havandat1523/School-Bus-Device/Doc/Hardware_design/master_PCB.png

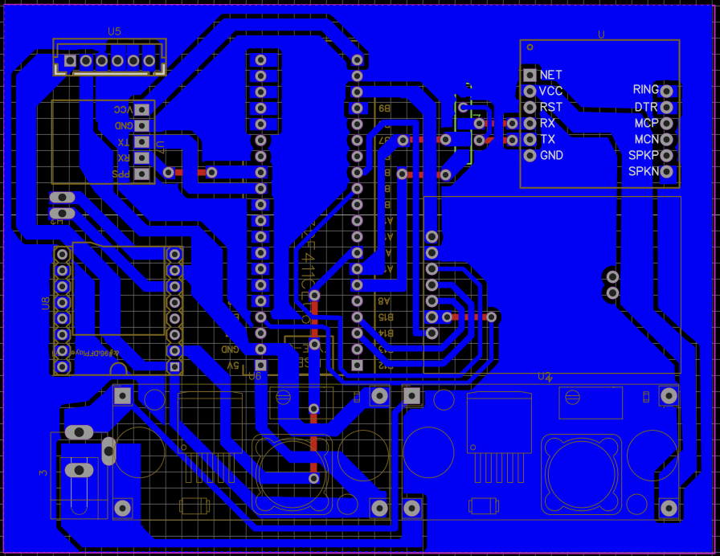
Doc/Hardware_design/master_PCB.png
