havandat1523/School-Bus-Device/Doc/Hardware_design/Slave_PCB_1.png

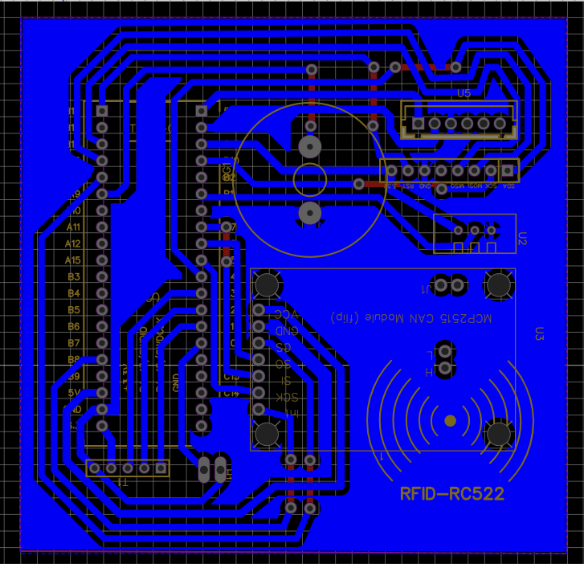
Doc/Hardware_design/Slave_PCB_1.png
