havandat1523/School-Bus-Device/Doc/Sequence_diagram/1.login_suscessful.png

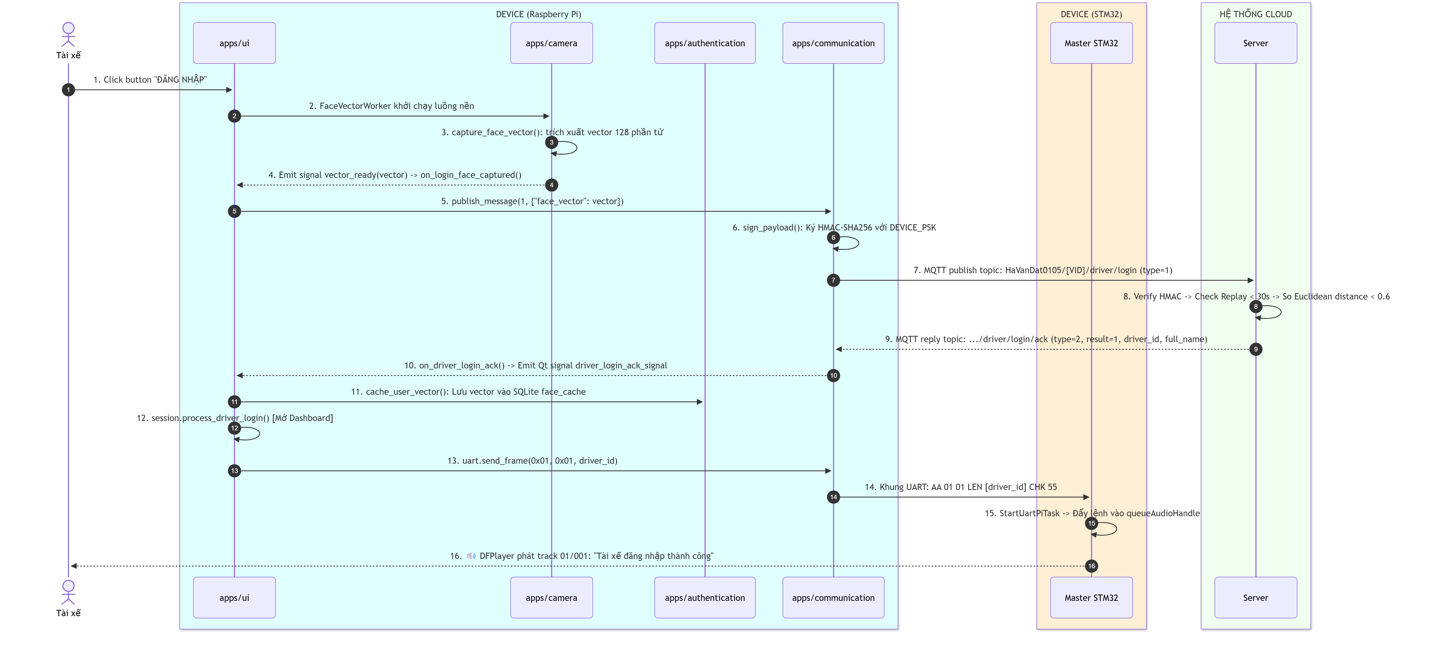
Doc/Sequence_diagram/1.login_suscessful.png
