havandat1523/School-Bus-Device/Doc/Sequence_diagram/2.Login_Failed.png

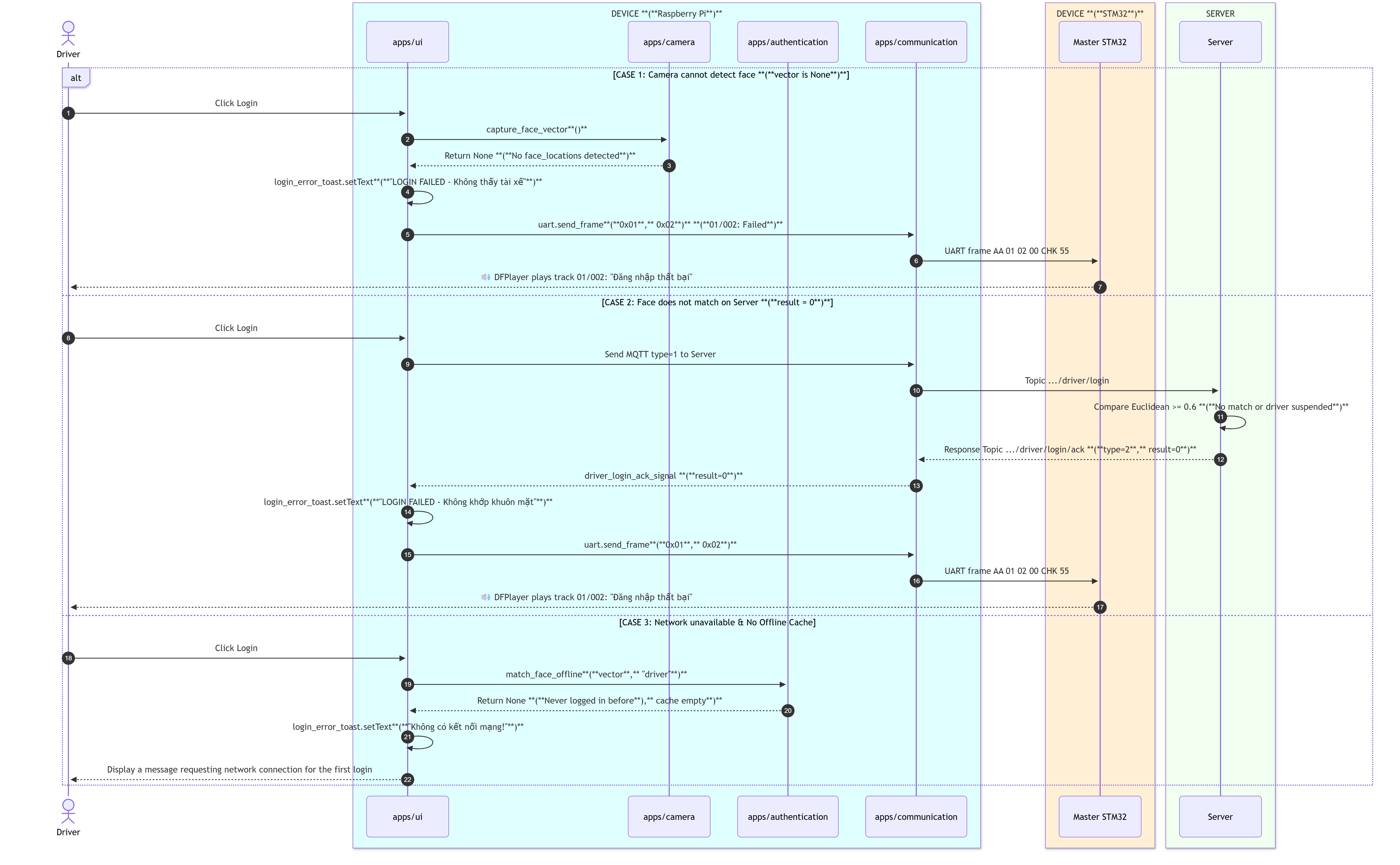
Doc/Sequence_diagram/2.Login_Failed.png
