havandat1523/School-Bus-Device/Doc/Sequence_diagram/3.Attandee_login_suscessful.png

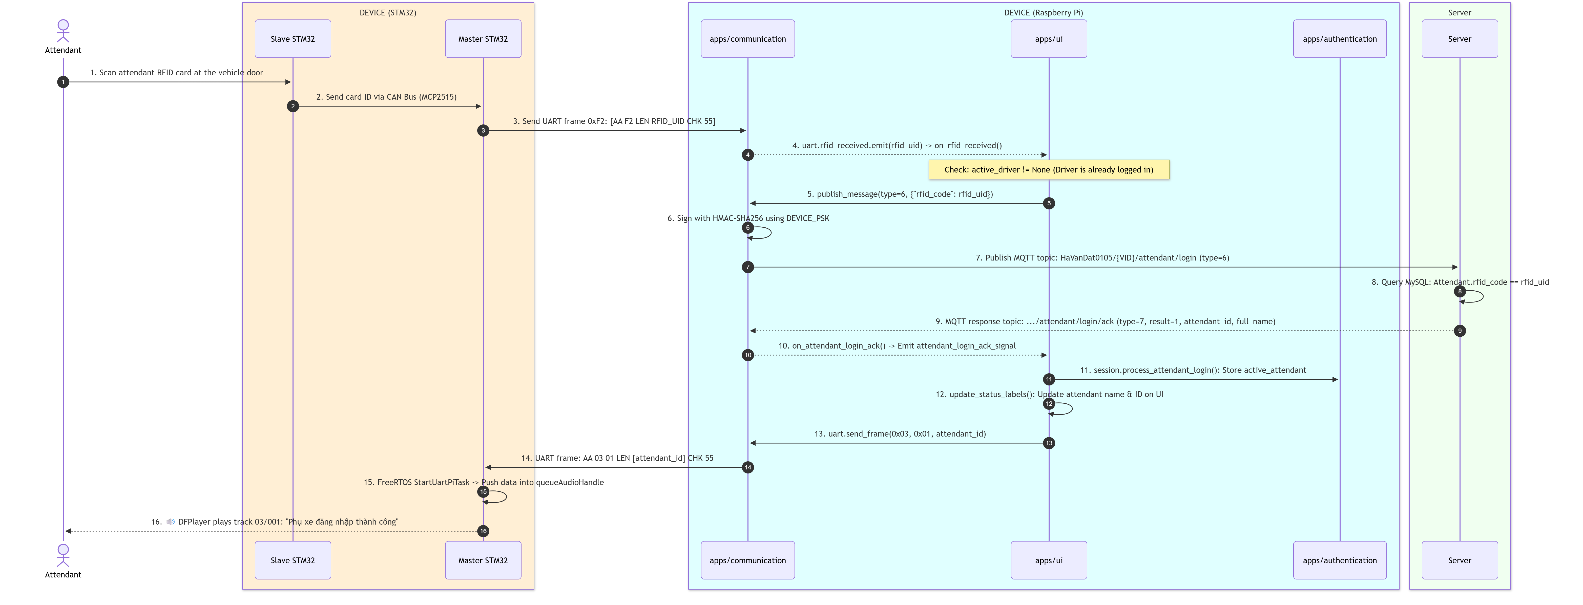
Doc/Sequence_diagram/3.Attandee_login_suscessful.png
