havandat1523/School-Bus-Device/Doc/Sequence_diagram/4.Attandee_login_failded.png

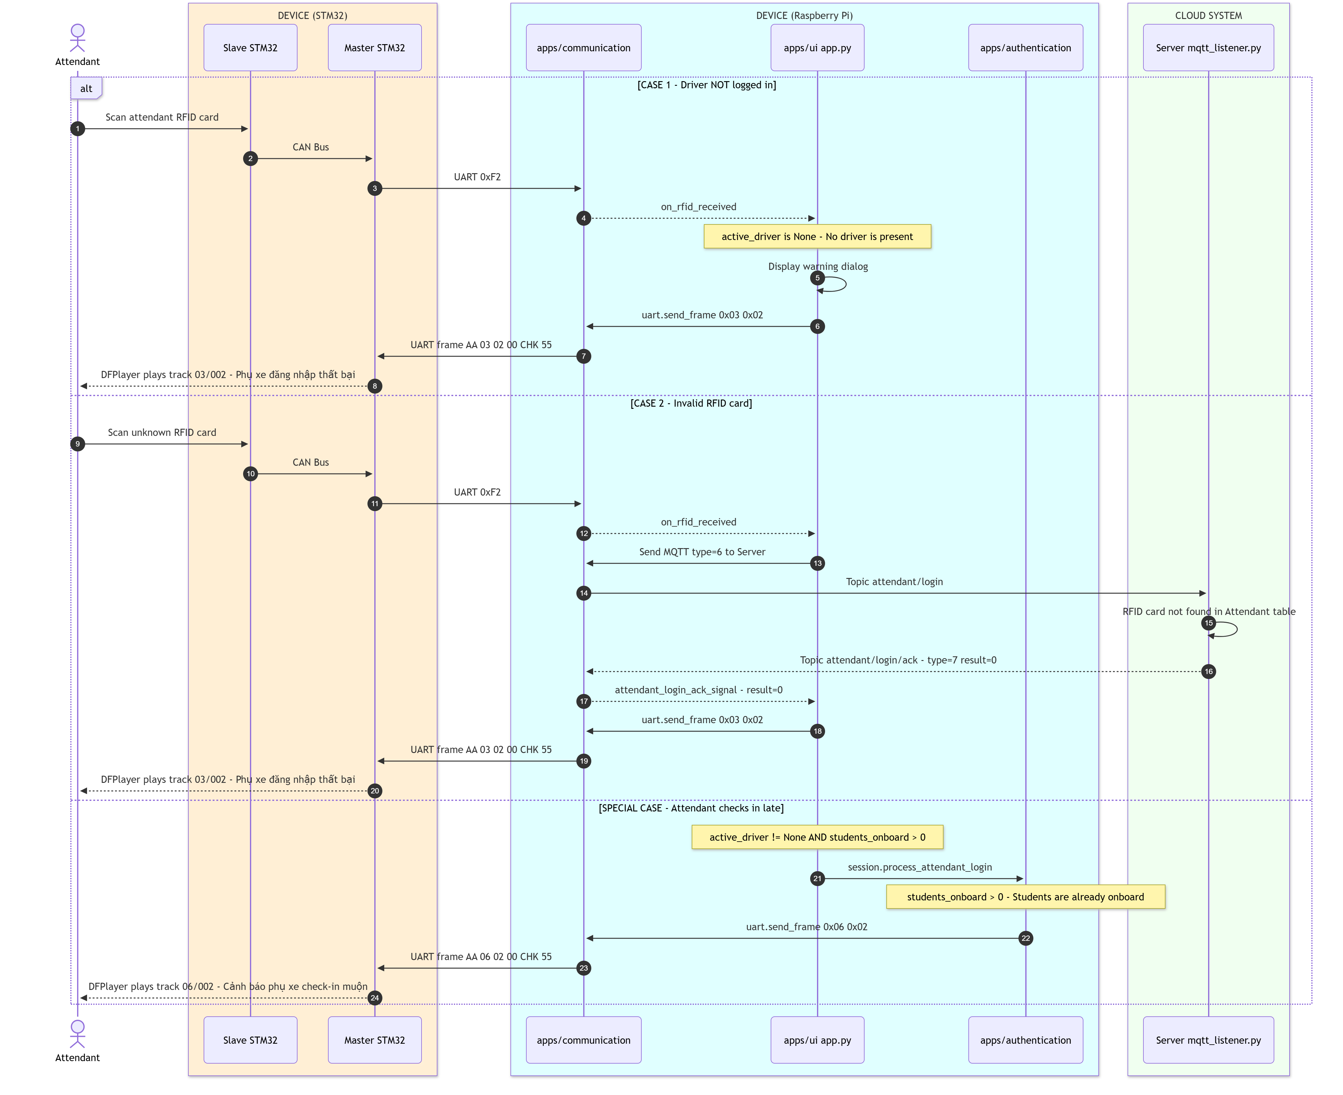
Doc/Sequence_diagram/4.Attandee_login_failded.png
