havandat1523/School-Bus-Device/Doc/Sequence_diagram/driver_send_SOS.png

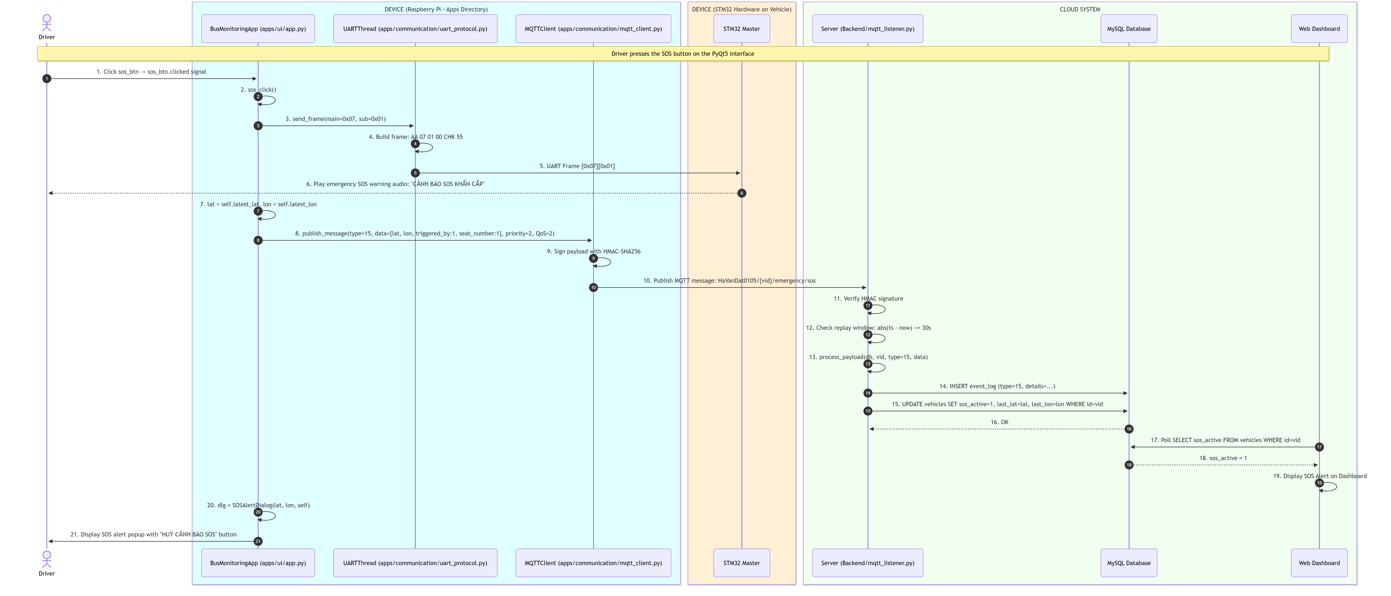
Doc/Sequence_diagram/driver_send_SOS.png
