havandat1523/School-Bus-Device/Doc/Sequence_diagram/Dropoff.png

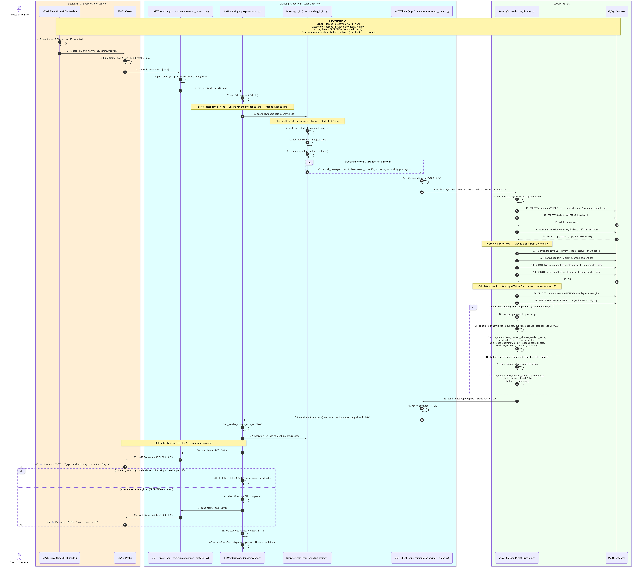
Doc/Sequence_diagram/Dropoff.png
