havandat1523/School-Bus-Device/Doc/Sequence_diagram/hocsinhquenquetthe.png

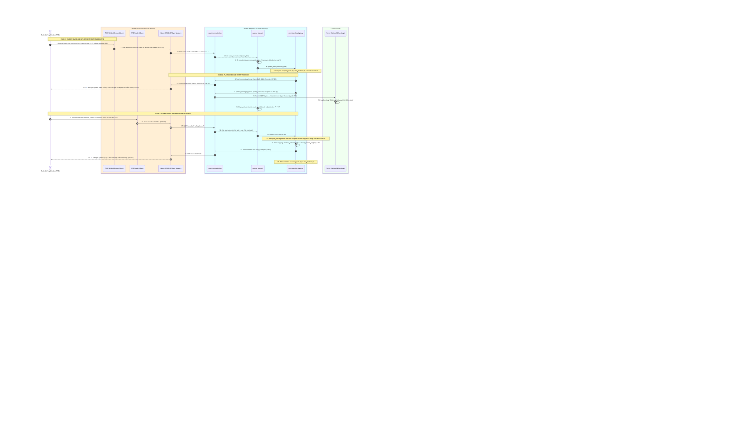
Doc/Sequence_diagram/hocsinhquenquetthe.png
