havandat1523/School-Bus-Device/Doc/Sequence_diagram/interval_gnss.png

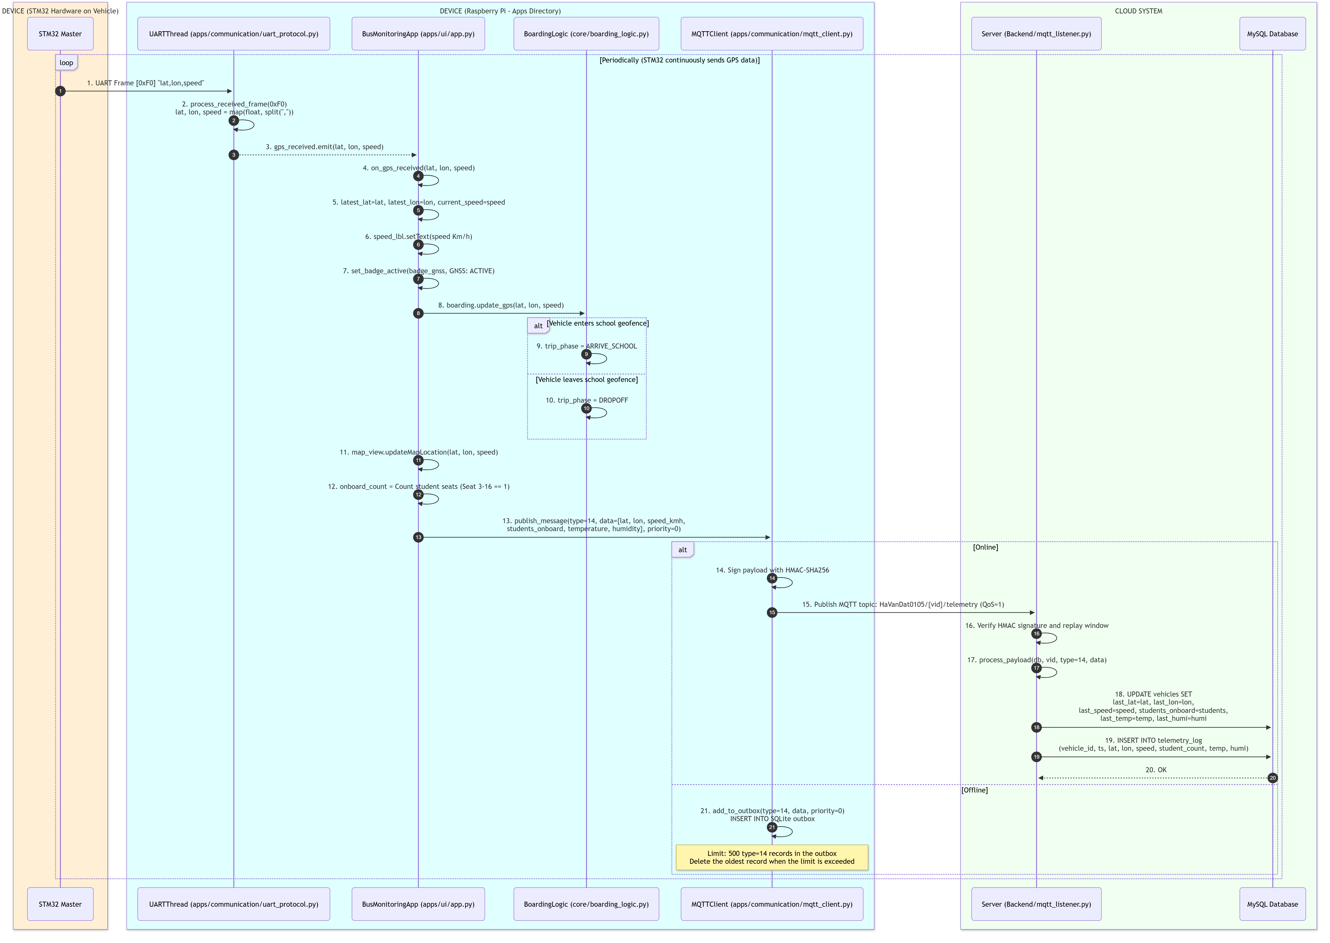
Doc/Sequence_diagram/interval_gnss.png
