havandat1523/School-Bus-Device/Doc/Sequence_diagram/interval_seat_thread.png

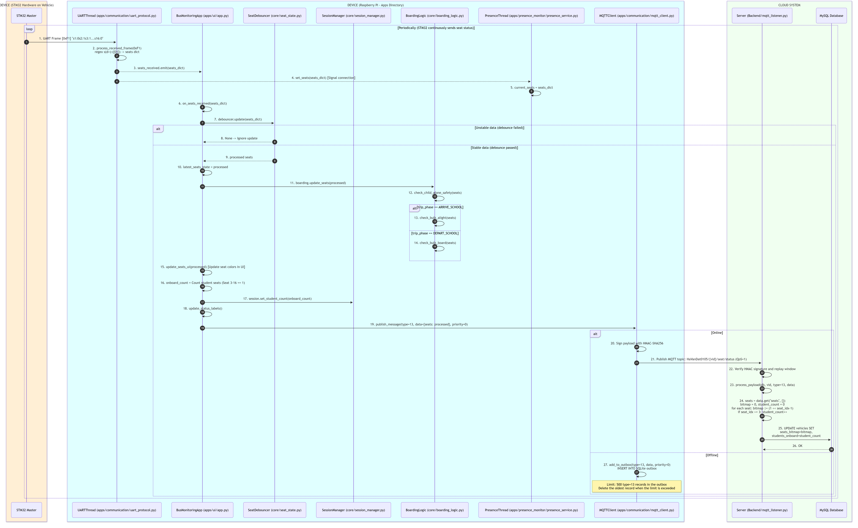
Doc/Sequence_diagram/interval_seat_thread.png
