havandat1523/School-Bus-Device/Doc/Sequence_diagram/pickup.png

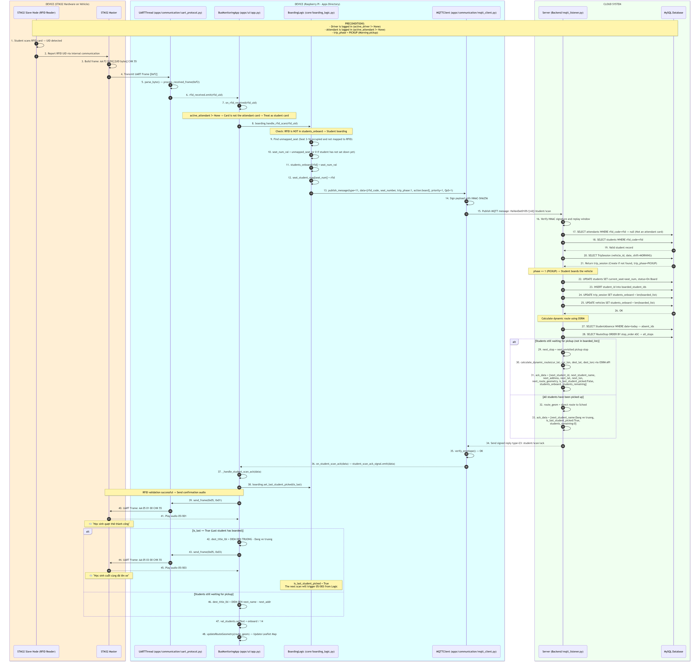
Doc/Sequence_diagram/pickup.png
