havandat1523/School-Bus-Device/Doc/Sequence_diagram/student_alone.png

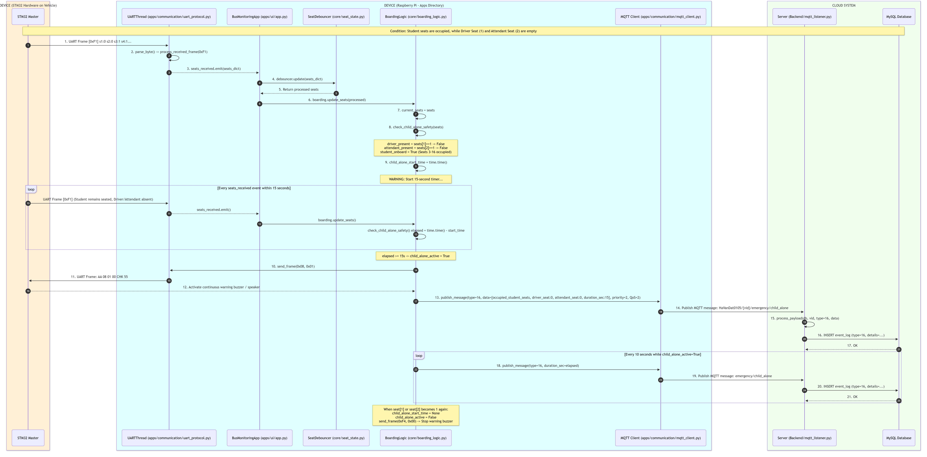
Doc/Sequence_diagram/student_alone.png
