havandat1523/School-Bus-Device/Doc/Sequence_diagram/trigger_SOS_physic_button.png

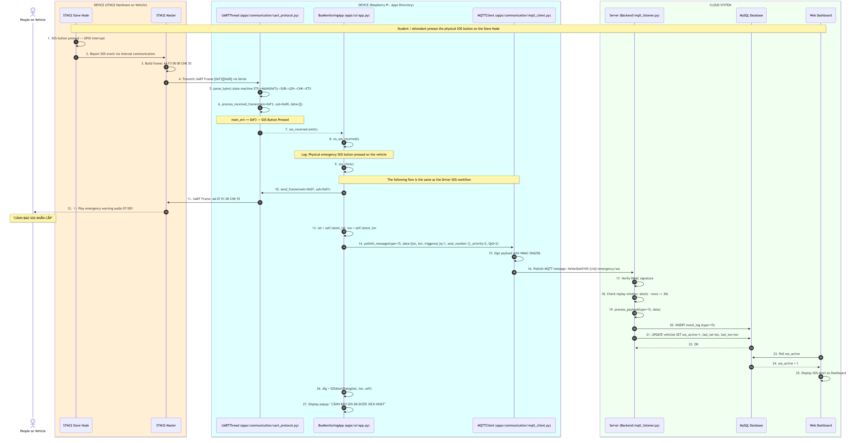
Doc/Sequence_diagram/trigger_SOS_physic_button.png
