havandat1523/School-Bus-Device/Doc/Sequence_diagram/violation_driver_attandee.png

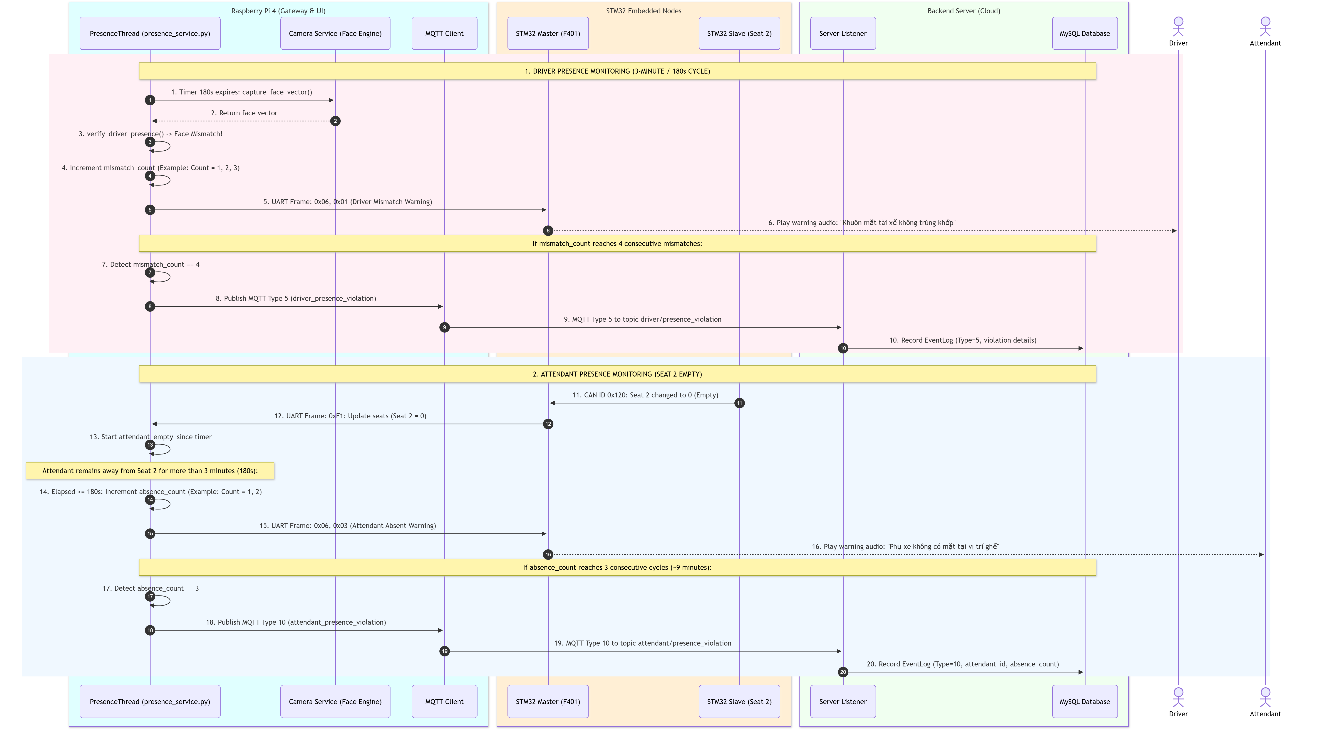
Doc/Sequence_diagram/violation_driver_attandee.png
