havandat1523/School-Bus-Device/Doc/Hardware_design/Master.pdf

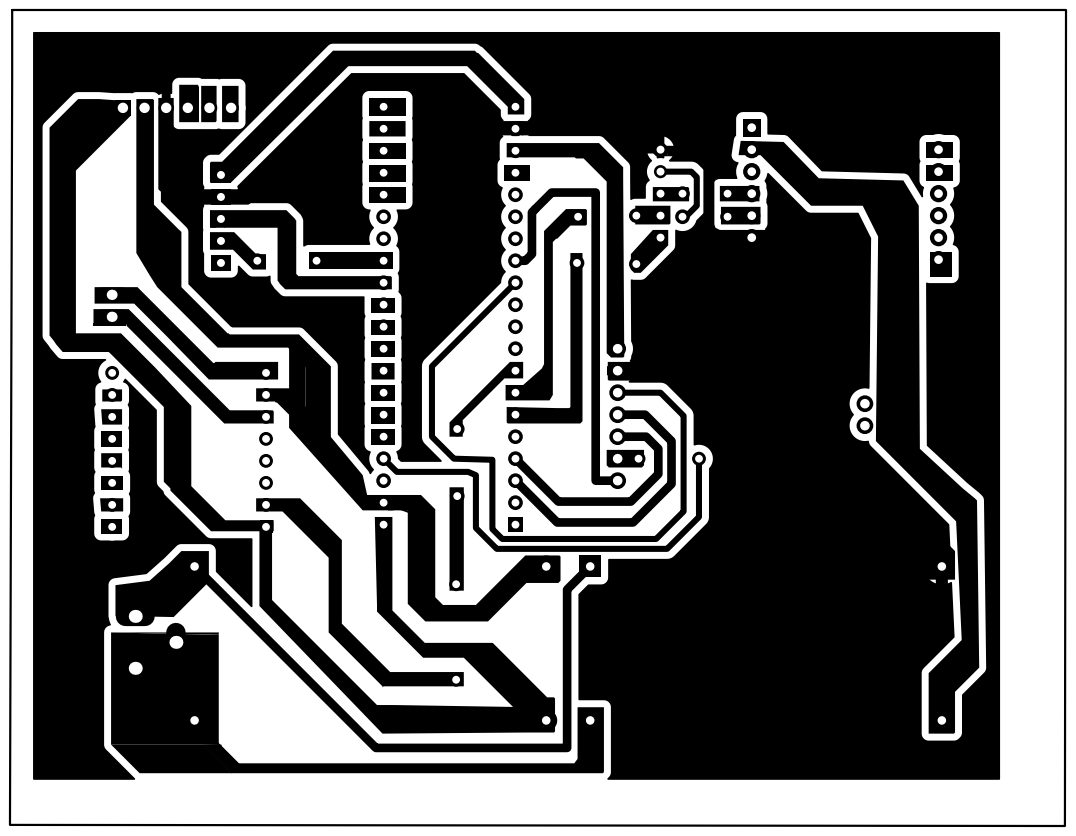
[picture p32: page 1]
