havandat1523/School-Bus-Device/Doc/Hardware_design/slave_1.pdf

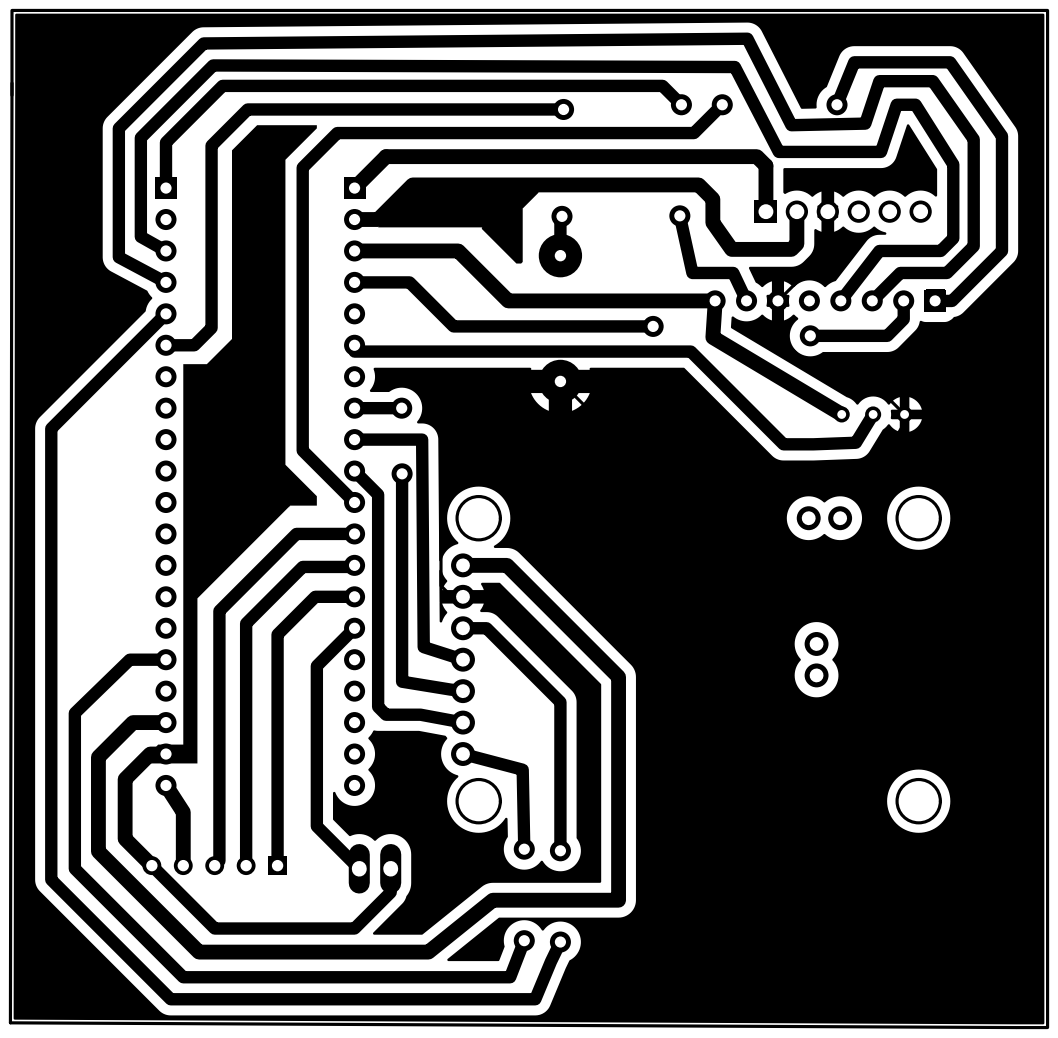
[picture p33: page 1]
