havandat1523/School-Bus-Device/Doc/Hardware_design/slave_2.pdf

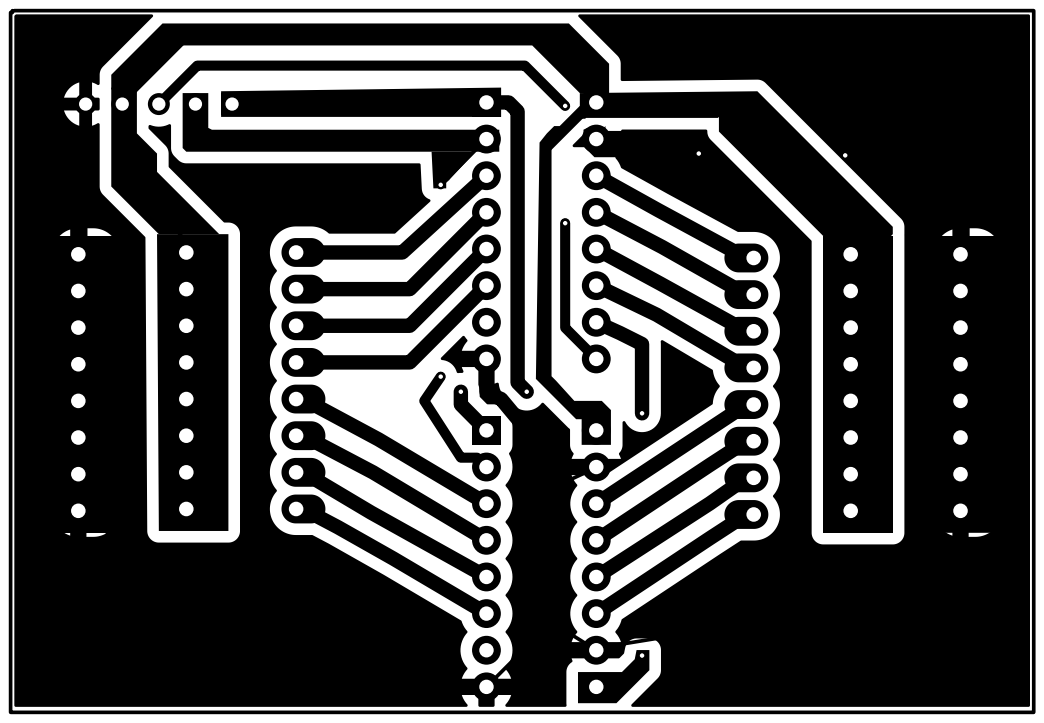
[picture p34: page 1]
