havandat1523/School-Bus-Device/Doc/UI_design/design_do_an.pdf

Giao diện đăng nhập

Số điện thoại của phụ huynh được lưu ở database Mật khẩu là mã thẻ của học sinh

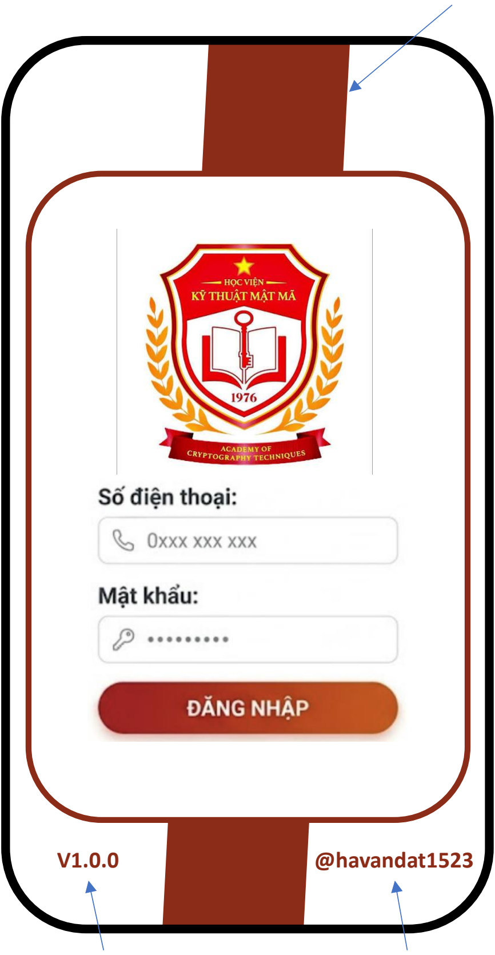
[picture p35: figure]
@havandat1523

Hai cái này lưu cứng ở đây , rất quan trọng

Cái thanh này làm cho nó chuyển động từ trái sang phải nếu làm cho nó dần chuyển màu giữa nâu đỏ và cam thì càng tốt

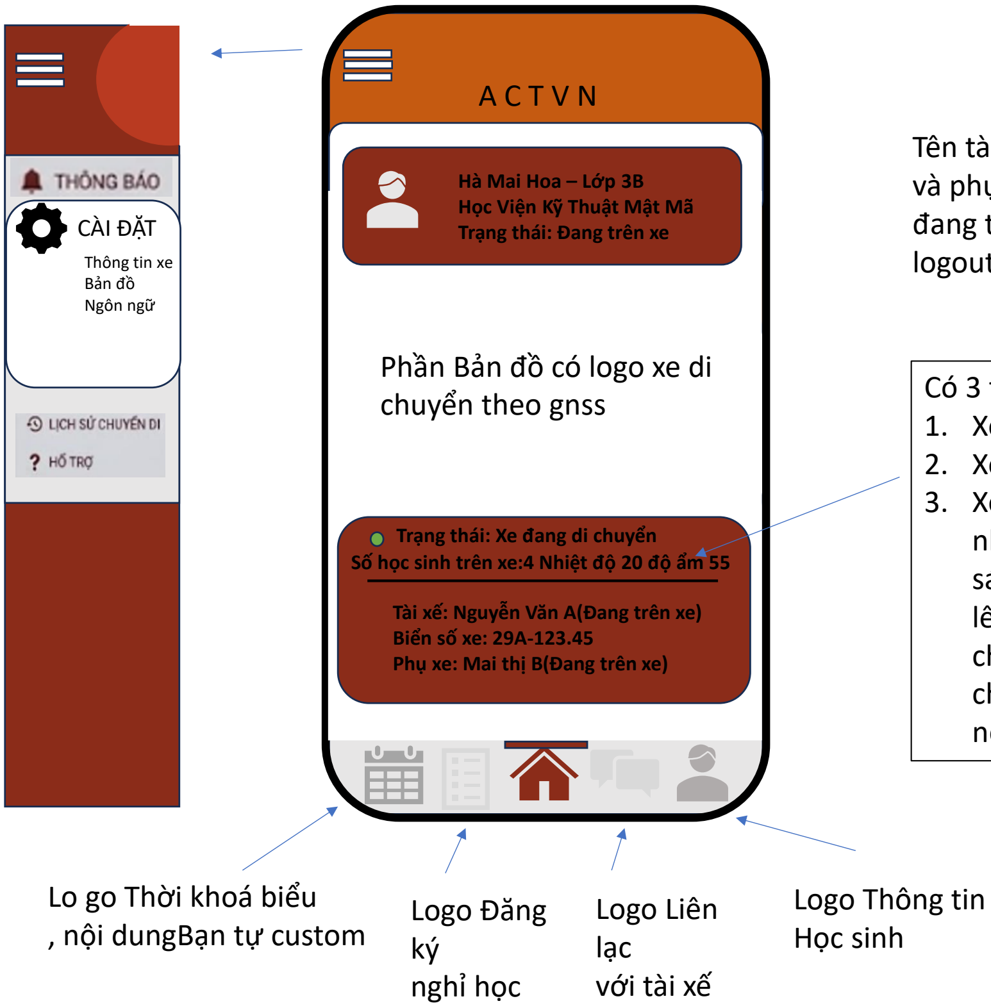
[picture p36: figure]
CÀI ĐẶT; Thông tin xe Bản đồ Ngôn ngữ; Tài xế: Nguyễn Văn A(Đang trên xe) Biển số xe: 29A-123.45 Phụ xe: Mai thị B(Đang trên xe); Trạng thái: Xe đang di chuyển; Hà Mai Hoa – Lớp 3B Học Viện Kỹ Thuật Mật Mã Trạng thái: Đang trên xe; Phần Bản đồ có logo xe di chuyển theo gnss; Lo go Thời khoá biểu , nội dungBạn tự custom; Logo Đăng ký nghỉ học; Logo Liên lạc với tài xế; Logo Thông tin Học sinh

Có 3 trạng thái của xe:
1. Xe đang dừng (tài xế log out)
2. Xe đang di chuyển
3. Xe đang đến vị trí của bạn(xác nhận khi học sinh trong danh sách trước học sinh này vừa lên xe nghĩa là xe đang di chuyển đến đón học sinh này, chuyển lại xe đang di chuyển nếu học sinh đang trên xe )

Tên tài xế + Phụ xe dựa theo tài xế và phụ xe login , chỉ có trạng thái đang trên xe ,nếu đang trạng thái logout thì sẽ là : không xác định

Số học sinh trên xe:4 Nhiệt độ 20 độ ẩm 55

Về số học sinh trên xe , nhiệt độ độ ẩm chỉ cập nhật khi tài xế login, nếu tài xế logout ghi không xác định

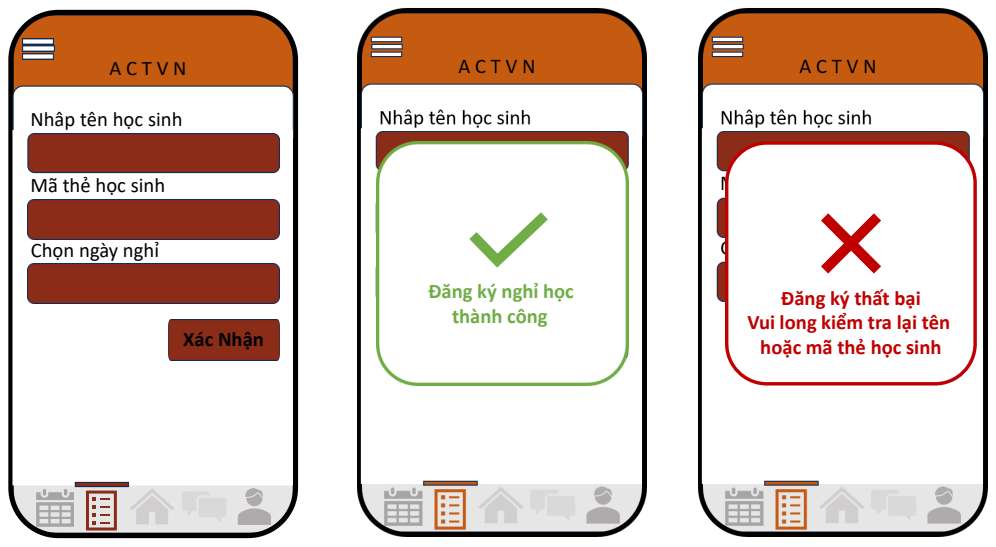
[picture p37: page 3]
Xác Nhận

Nhâp tên học sinh

Mã thẻ học sinh

Chọn ngày nghỉ

Đăng ký nghỉ học
thành công

Đăng ký thất bại
Vui long kiểm tra lại tên
hoặc mã thẻ học sinh

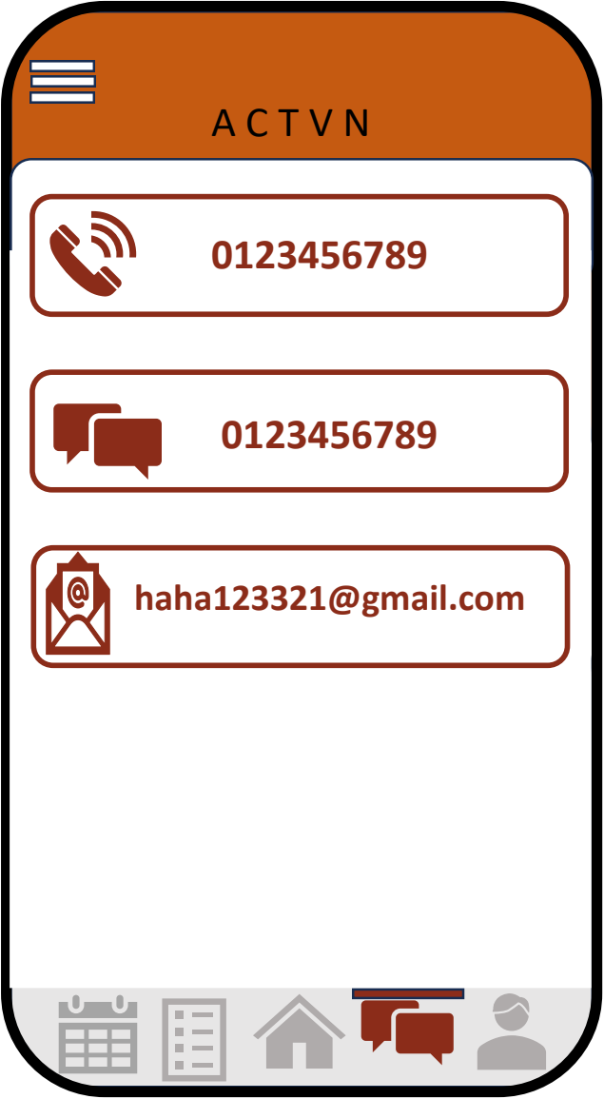
[picture p38: figure]
haha123321@gmail.com

Nếu phần liên lạc với tài xế sẽ hiển thị số điện thoại, gmail mà tài xế đã login, nếu chưa có tài xế login thì nó sẽ hiện : Chưa xác định. Nhấn logo nào sẽ mở app tương ứng trên điện thoại

Phần học sinh vẫn làm tương tự hiển thị các trường thông tin như họ tên , trường học , mã thẻ, tên phụ huynh , số điện thoại phụ huynh, địa chỉ

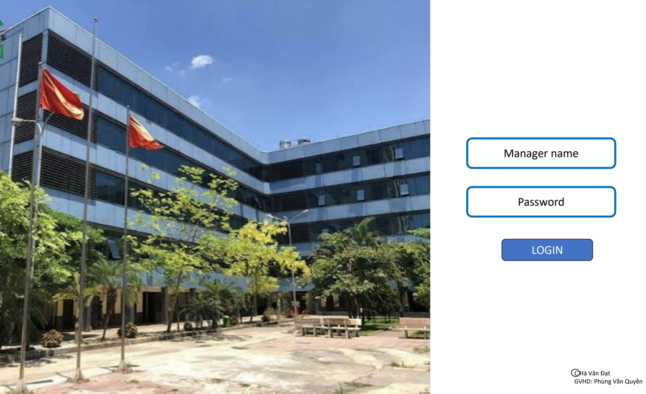
[picture p39: page 5]

Manager name

Password

LOGIN

C Hà Văn Đạt
GVHD: Phùng Văn Quyền

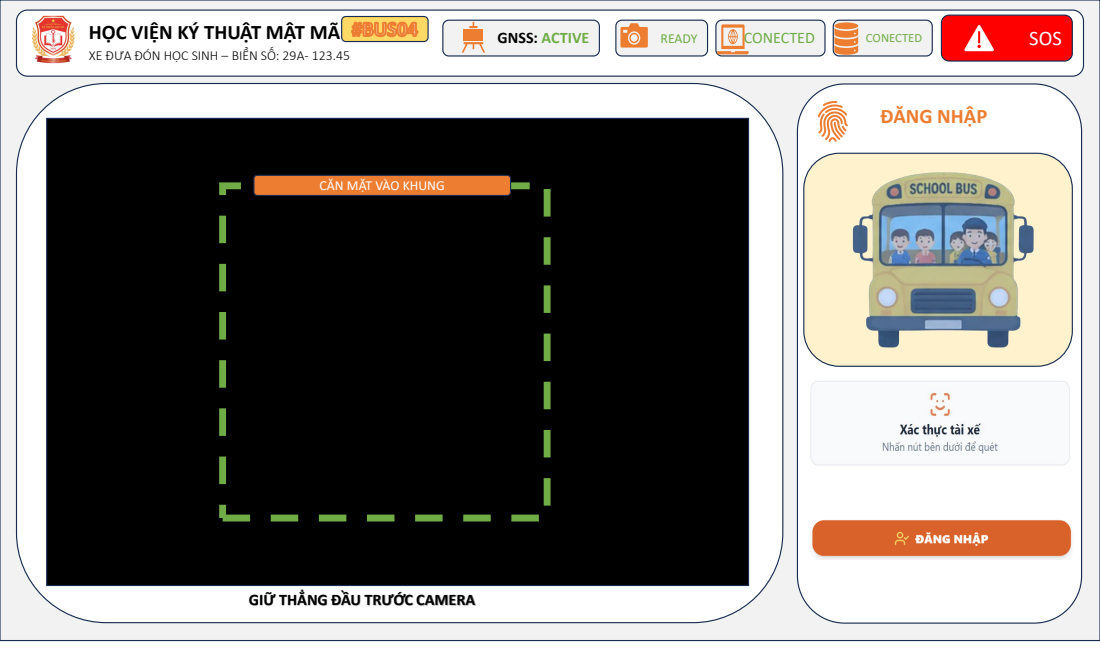
[picture p40: page 6]
HỌC VIỆN KÝ THUẬT MẬT MÃ; GNSS: ACTIVE; READY; CONECTED; SOS; #BUS04; ĐĂNG NHẬP

XE ĐƯA ĐÓN HỌC SINH – BIỂN SỐ: 29A- 123.45

CĂN MẶT VÀO KHUNG

GIỮ THẲNG ĐẦU TRƯỚC CAMERA

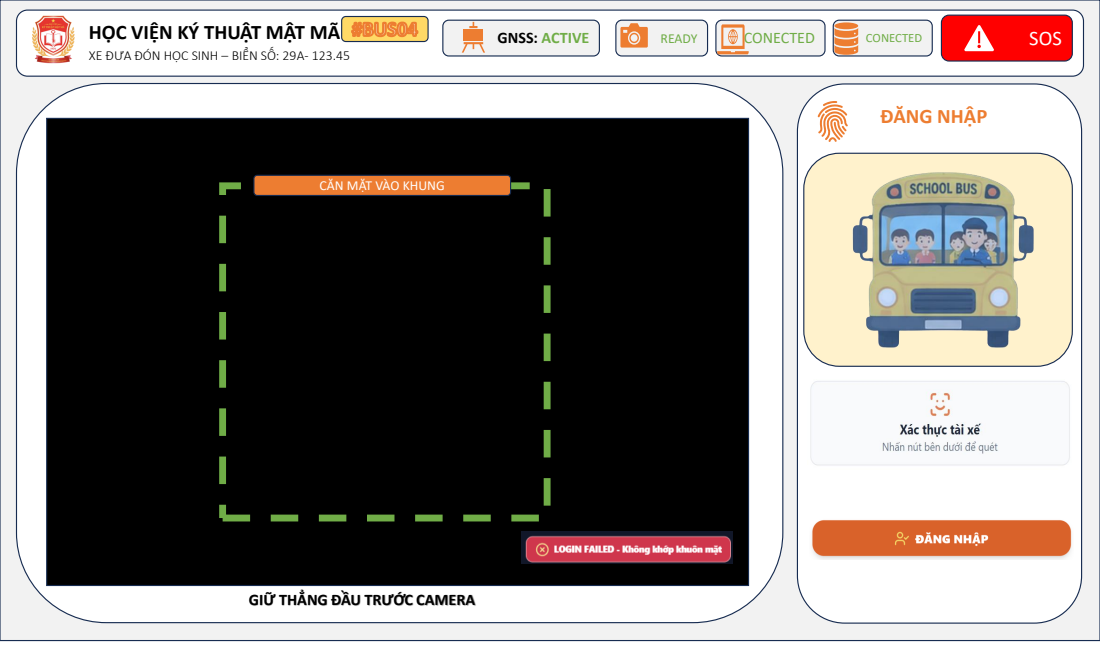
[picture p41: page 7]
ĐĂNG NHẬP

XE ĐƯA ĐÓN HỌC SINH – BIỂN SỐ: 29A- 123.45

CĂN MẶT VÀO KHUNG

GIỮ THẲNG ĐẦU TRƯỚC CAMERA

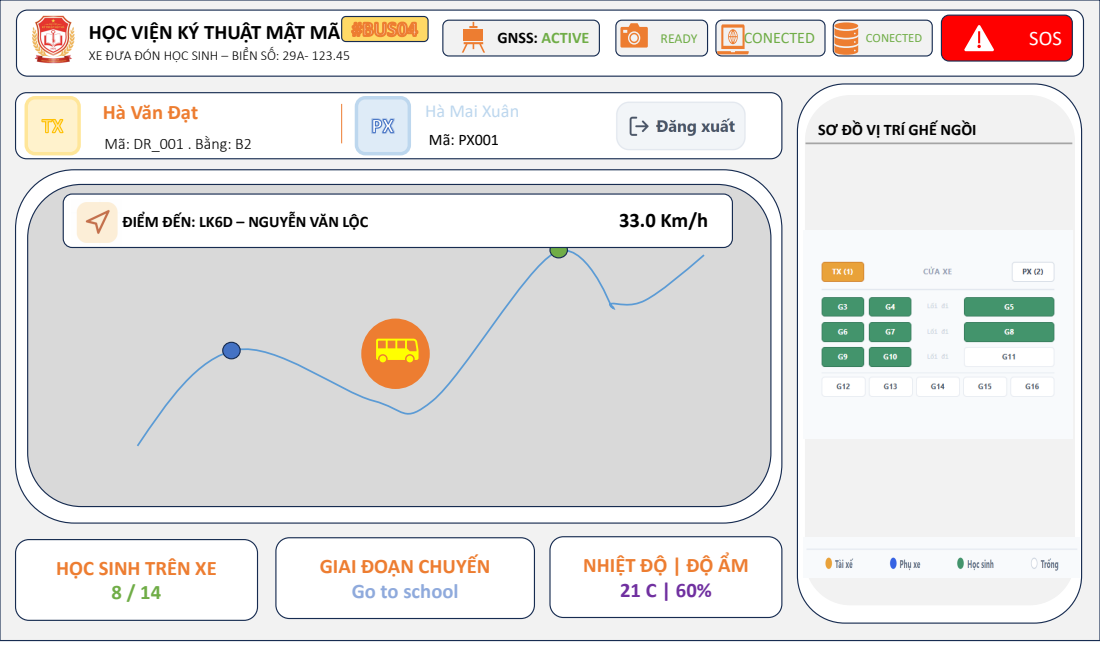
[picture p42: page 8]
Mã: DR_001 . Bằng: B2; ĐIỂM ĐẾN: LK6D – NGUYỄN VĂN LỘC

XE ĐƯA ĐÓN HỌC SINH – BIỂN SỐ: 29A- 123.45

Hà Văn Đạt

Hà Mai Xuân

SƠ ĐỒ VỊ TRÍ GHẾ NGỒI

GIAI ĐOẠN CHUYẾN
Go to school

NHIỆT ĐỘ | ĐỘ ẨM

HỌC SINH TRÊN XE

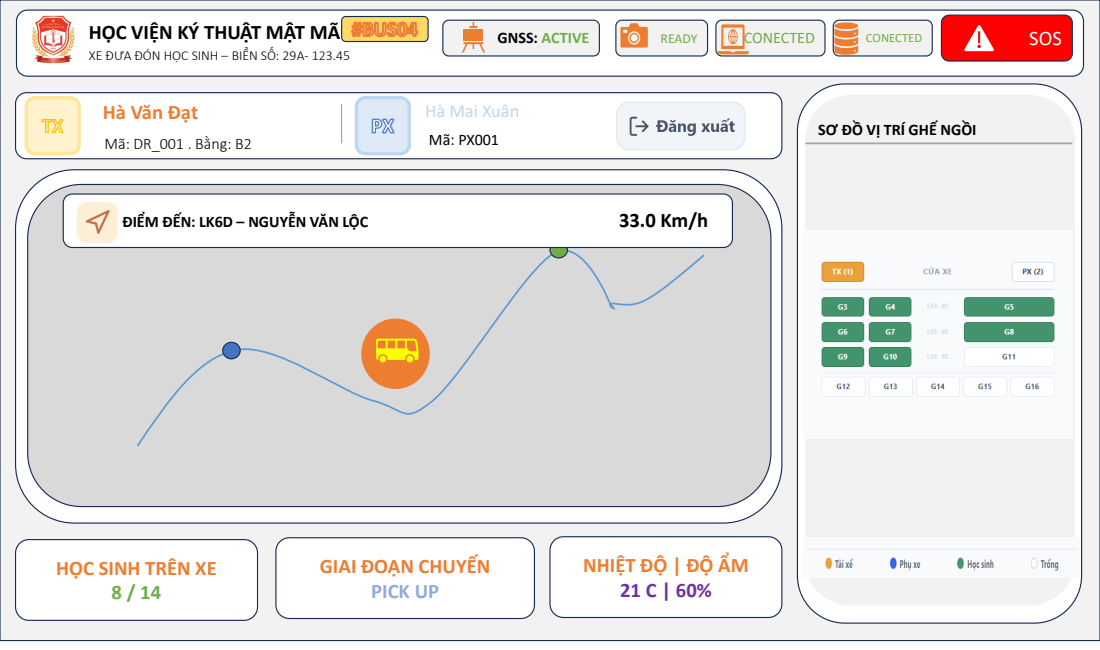
[picture p43: page 9]
Mã: DR_001 . Bằng: B2; ĐIỂM ĐẾN: LK6D – NGUYỄN VĂN LỘC

XE ĐƯA ĐÓN HỌC SINH – BIỂN SỐ: 29A- 123.45

Hà Văn Đạt

Hà Mai Xuân

SƠ ĐỒ VỊ TRÍ GHẾ NGỒI

GIAI ĐOẠN CHUYẾN
PICK UP

NHIỆT ĐỘ | ĐỘ ẨM

HỌC SINH TRÊN XE

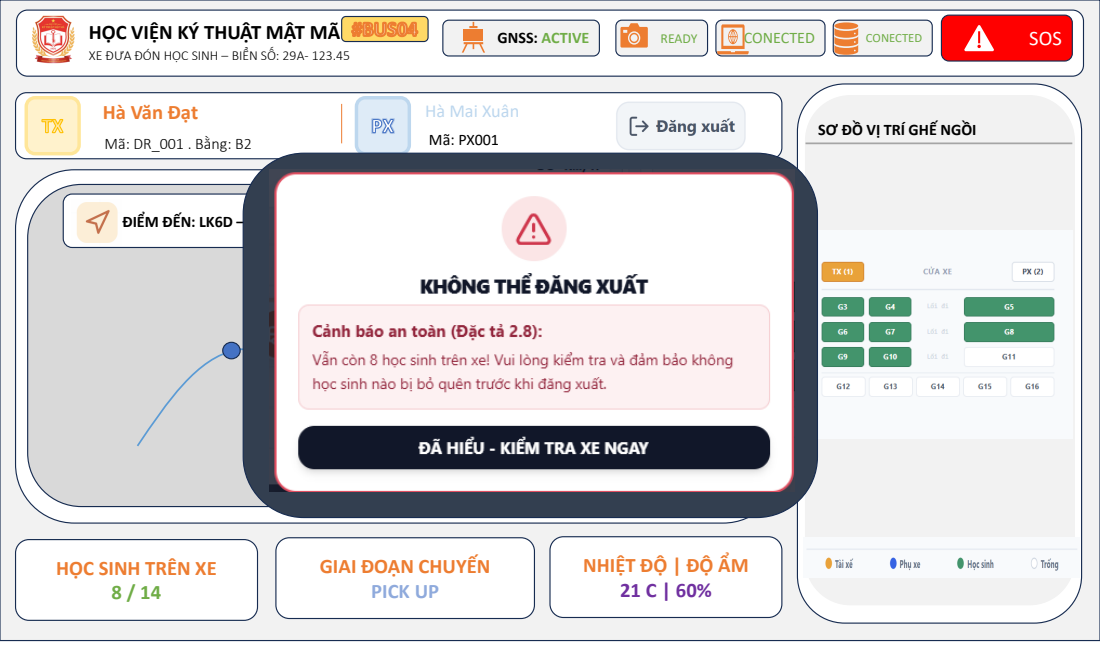
[picture p44: page 10]
Mã: DR_001 . Bằng: B2; ĐIỂM ĐẾN: LK6D – NGUYỄN VĂN LỘC

XE ĐƯA ĐÓN HỌC SINH – BIỂN SỐ: 29A- 123.45

Hà Văn Đạt

Hà Mai Xuân

SƠ ĐỒ VỊ TRÍ GHẾ NGỒI

GIAI ĐOẠN CHUYẾN
PICK UP

NHIỆT ĐỘ | ĐỘ ẨM

HỌC SINH TRÊN XE

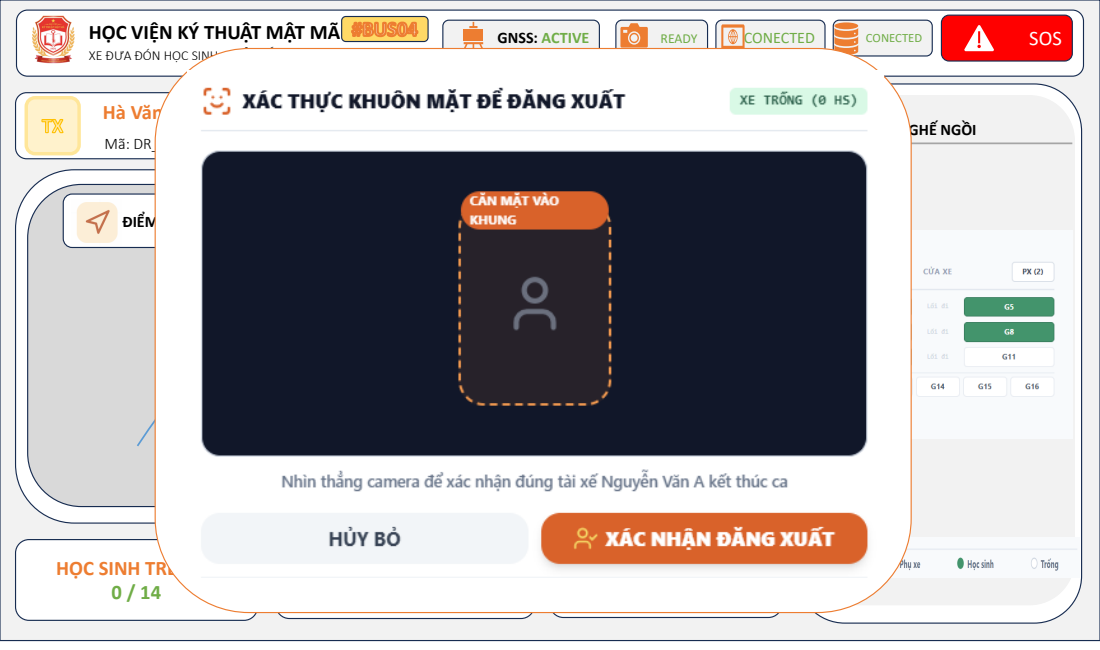
[picture p45: page 11]
Mã: DR_001 . Bằng: B2; ĐIỂM ĐẾN: LK6D – NGUYỄN VĂN LỘC

XE ĐƯA ĐÓN HỌC SINH – BIỂN SỐ: 29A- 123.45

Hà Văn Đạt

Hà Mai Xuân

SƠ ĐỒ VỊ TRÍ GHẾ NGỒI

GIAI ĐOẠN CHUYẾN
PICK UP

NHIỆT ĐỘ | ĐỘ ẨM

HỌC SINH TRÊN XE

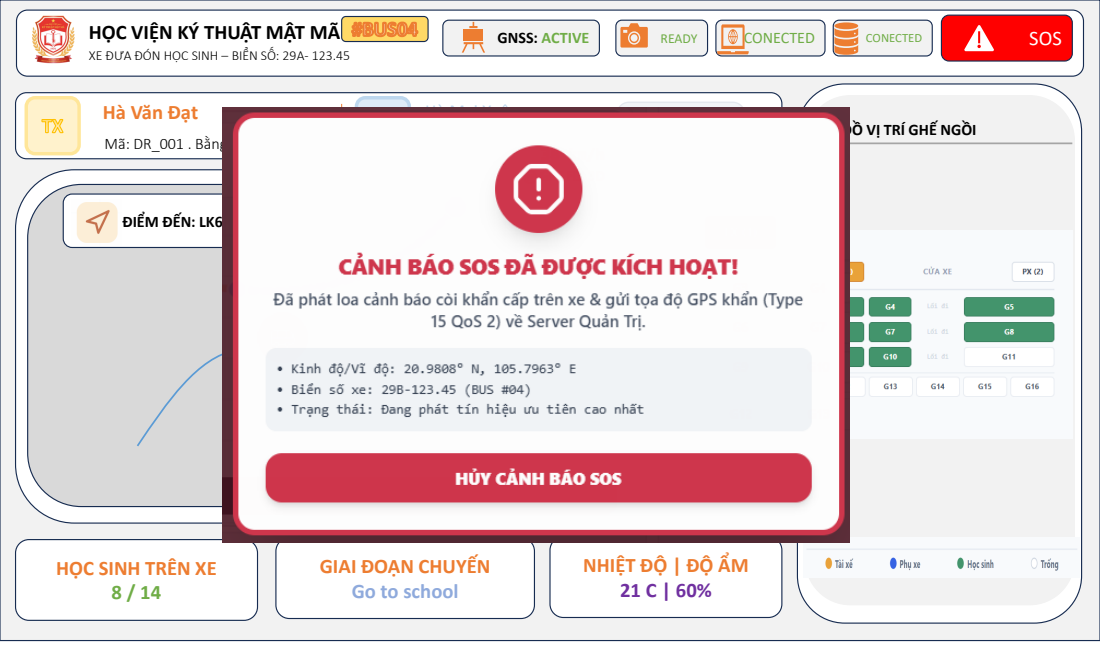
[picture p46: page 12]
Mã: DR_001 . Bằng: B2; ĐIỂM ĐẾN: LK6D – NGUYỄN VĂN LỘC

XE ĐƯA ĐÓN HỌC SINH – BIỂN SỐ: 29A- 123.45

Hà Văn Đạt

Hà Mai Xuân

SƠ ĐỒ VỊ TRÍ GHẾ NGỒI

GIAI ĐOẠN CHUYẾN
Go to school

NHIỆT ĐỘ | ĐỘ ẨM

HỌC SINH TRÊN XE
