havandat1523/School-Bus-Device/RaspberryPi/main.py

import sys
import os
from PyQt5.QtWidgets import QApplication
from config import config
from services.logger import get_logger
from services.database import init_db
from apps.communication.uart_protocol import UARTThread
from apps.communication.mqtt_client import MQTTClient
from apps.communication.payload_handler import PayloadHandler
from apps.camera.camera_service import CameraService
from apps.authentication.auth_service import AuthService
from apps.presence_monitor.presence_service import PresenceThread
from core.session_manager import SessionManager
from core.boarding_logic import BoardingLogic
from core.seat_state import SeatDebouncer
from apps.gpio_handler.gpio_handler import GPIOHandler
from apps.ui.app import BusMonitoringApp

logger = get_logger("Main")

def main():
    logger.info("==============================================")
    logger.info("Starting School Bus Gateway Application...")
    logger.info("VEHICLE ID: %s", config.VEHICLE_ID)
    logger.info("DISPLAY: %s", os.environ.get("DISPLAY", "Not Set"))
    logger.info("==============================================")

    # 1. Initialize PyQt5 GUI Application first (Qt core requirement)
    app = QApplication(sys.argv)

    # 2. Initialize SQLite Database
    init_db()

    # 3. Instantiate core services
    auth_service = AuthService()

    # 4. Instantiate thread components
    camera_service = CameraService()
    uart_thread = UARTThread()

    # 5. Instantiate MQTT client
    mqtt_client = MQTTClient()

    # 6. Instantiate managers & logic layers
    session_manager = SessionManager(auth_service, uart_thread, mqtt_client)
    boarding_logic = BoardingLogic(uart_thread, mqtt_client)

    # F1+F2: SeatDebouncer nhận callback → khi ghế học sinh 0→1 trigger finalize boarding
    seat_debouncer = SeatDebouncer(
        on_seat_occupied=boarding_logic._try_finalize_boarding
    )

    # F1+F2+F3: PayloadHandler xử lý lệnh từ Server và quản lý SOS
    payload_handler = PayloadHandler(
        boarding_logic=boarding_logic,
        uart_thread=uart_thread,
        mqtt_client=mqtt_client,
        session_manager=session_manager
    )

    # Gán payload_handler vào mqtt_client để nhận type=20 action F1/F2
    mqtt_client.payload_handler = payload_handler

    # 7. Instantiate presence check thread
    presence_thread = PresenceThread(auth_service, camera_service, uart_thread, mqtt_client)

    # 8. Create main UI window & connect signals
    ui_app = BusMonitoringApp(
        uart_thread=uart_thread,
        mqtt_client=mqtt_client,
        camera_service=camera_service,
        auth_service=auth_service,
        session_manager=session_manager,
        boarding_logic=boarding_logic,
        seat_debouncer=seat_debouncer,
        payload_handler=payload_handler
    )

    # Link MQTT callback receiver to UI
    mqtt_client.callback_handler = ui_app

    # Wire seat updates: UART → SeatDebouncer callback → boarding_logic
    uart_thread.seats_received.connect(presence_thread.set_seats)

    # Wire RFID signal: UART → boarding_logic F2 queue (thay vì gọi trực tiếp)
    # boarding_logic.handle_rfid_scan sẽ tự push vào pending queue và gửi validate
    uart_thread.rfid_received.connect(boarding_logic.handle_rfid_scan)

    # F4: GPIO Handler cho 2 nút bấm vật lý trên Pi (Login/Logout toggle và SOS 3s hold)
    gpio_handler = GPIOHandler(
        login_pin=config.GPIO_LOGIN_PIN,
        sos_pin=config.GPIO_SOS_PIN,
        sos_hold_sec=config.GPIO_SOS_HOLD_SEC,
        on_login_toggle=ui_app.on_gpio_login_toggle,
        on_sos_triggered=ui_app.on_gpio_sos_triggered,
        on_sos_progress=ui_app.on_gpio_sos_progress
    )

    # Show UI window
    ui_app.show()

    # 9. Start background threads AFTER QApplication, UI, and Signals are connected
    camera_service.start()
    uart_thread.start()
    mqtt_client.start()
    presence_thread.start()
    gpio_handler.start()

    # Execute Qt main event loop
    logger.info("UI Window launched. Entering Qt main loop.")
    exit_code = app.exec_()

    # Cleanup threads on exit
    logger.info("Shutting down threads...")
    gpio_handler.stop()
    camera_service.stop()
    uart_thread.stop()
    mqtt_client.stop()
    presence_thread.stop()
    logger.info("Application exited with code %d", exit_code)
    sys.exit(exit_code)

if __name__ == "__main__":
    main()
