havandat1523/School-Bus-Device/STM32/Slave/Core/Inc/main.h

#define SOS_KEY_Pin GPIO_PIN_0
#define SOS_KEY_GPIO_Port GPIOA
#define SOS_KEY_EXTI_IRQn EXTI0_IRQn
#define HC165_PL_Pin GPIO_PIN_1
#define HC165_PL_GPIO_Port GPIOA
#define HC165_CLK_Pin GPIO_PIN_2
#define HC165_CLK_GPIO_Port GPIOA
#define HC165_DATA_Pin GPIO_PIN_3
#define HC165_DATA_GPIO_Port GPIOA
#define RFID_CS_Pin GPIO_PIN_4
#define RFID_CS_GPIO_Port GPIOA
#define DHT11_PIN_Pin GPIO_PIN_1
#define DHT11_PIN_GPIO_Port GPIOB
#define RFID_RST_Pin GPIO_PIN_12
#define RFID_RST_GPIO_Port GPIOB
#define CAN_CS_Pin GPIO_PIN_8
#define CAN_CS_GPIO_Port GPIOA
#define CAN_INT_Pin GPIO_PIN_8
#define CAN_INT_GPIO_Port GPIOB
#define CAN_INT_EXTI_IRQn EXTI9_5_IRQn
#define BUZZER_Pin GPIO_PIN_9
#define BUZZER_GPIO_Port GPIOA
