havandat1523/School-Bus-Device/RaspberryPi/core/session_manager.py

from services.logger import get_logger

logger = get_logger("SessionManager")

class SessionManager:
    def __init__(self, auth_service, uart_thread, mqtt_client):
        self.auth = auth_service
        self.uart = uart_thread
        self.mqtt = mqtt_client
        self.students_onboard = 0
        self.driver_phone_number = None
        self.is_pending_confirm = False

    def set_pending_confirm(self, pending: bool):
        """Khóa hoặc mở khóa nút đăng nhập khi đang PENDING_CONFIRM."""
        self.is_pending_confirm = pending
        logger.info("Session pending_confirm state set to: %s", pending)

    def set_student_count(self, count: int):
        self.students_onboard = count

    def toggle_login_logout(self, student_count: int = 0) -> tuple:
        """
        F4: Nút GPIO vật lý 1 — Toggle Login / Logout.
        - Bị khoá khi PENDING_CONFIRM (đang chờ xác nhận trung tâm).
        - Chưa login → Trả về ("LOGIN_REQUEST", "")
        - Đã login → Kiểm tra can_driver_logout(), nếu thoả mãn thì trả về ("LOGOUT_REQUEST", "")
        Returns: (status: str, message: str)
        """
        if self.is_pending_confirm:
            logger.warning("F4: GPIO Login/Logout button LOCKED — session is PENDING_CONFIRM!")
            # 01/003: Hệ thống đang bận, vui lòng thử lại
            self.uart.send_frame(0x01, 0x03)
            return "LOCKED", "Hệ thống đang chờ trung tâm xác nhận phiên cũ, vui lòng thử lại sau!"

        if not self.auth.active_driver:
            logger.info("F4: GPIO button triggered driver LOGIN request")
            return "LOGIN_REQUEST", "Yêu cầu đăng nhập tài xế"

        # Đang có tài xế đăng nhập -> Yêu cầu đăng xuất
        can_logout, reason = self.can_driver_logout(student_count)
        if not can_logout:
            logger.warning("F4/F5: GPIO driver logout REJECTED: %s", reason)
            # F5: 02/004: Đăng xuất thất bại — còn học sinh hoặc phụ xe
            self.uart.send_frame(0x02, 0x04)
            return "REJECTED", reason

        logger.info("F4: GPIO button triggered driver LOGOUT request")
        return "LOGOUT_REQUEST", "Yêu cầu đăng xuất tài xế"

    def can_attendant_logout(self, student_count: int = 0) -> tuple:
        """
        Validates if the attendant is allowed to logout.
        Rule: Attendant can ONLY logout when NO students are left on board (all reached school or home).
        Returns (bool, reason_string).
        """
        if not self.auth.active_attendant:
            return False, "Không có phụ xe nào đang đăng nhập."
            
        effective_students = max(self.students_onboard, student_count)
        if effective_students > 0:
            return False, f"Vẫn còn {effective_students} học sinh trên xe! Phụ xe phải đợi tất cả học sinh xuống xe hết (đến trường hoặc về nhà) mới được đăng xuất."
            
        return True, ""

    def can_driver_logout(self, student_count: int = 0) -> tuple:
        """
        Validates if the driver is allowed to logout.
        Rule:
        1. Driver can only logout AFTER attendant has logged out.
        2. Driver can only logout when NO students are on board.
        Returns (bool, reason_string).
        """
        if not self.auth.active_driver:
            return False, "Không có tài xế nào đang đăng nhập."
            
        if self.auth.active_attendant:
            att_name = self.auth.active_attendant.get("full_name", "Phụ xe")
            return False, f"Phụ xe ({att_name}) vẫn còn trên xe! Phụ xe phải đăng xuất trước khi tài xế đăng xuất."
            
        effective_students = max(self.students_onboard, student_count)
        if effective_students > 0:
            return False, f"Vẫn còn {effective_students} học sinh trên xe! Tài xế không thể đăng xuất."
            
        return True, ""

    def process_driver_login(self, driver_id: str, full_name: str, face_vector: list = None, phone_number: str = None):
        """
        Saves the logged in driver profile.
        """
        self.driver_phone_number = phone_number
        self.auth.active_driver = {
            "driver_id": driver_id,
            "full_name": full_name,
            "face_vector": face_vector,
            "phone_number": phone_number
        }
        self.auth.mismatch_count = 0
        logger.info("Driver logged in: %s (%s, Phone: %s)", full_name, driver_id, phone_number)
        # Notify Master via UART to play 01/001 (driver login success)
        self.uart.send_frame(0x01, 0x01, driver_id.encode("ascii"))

    def process_driver_logout(self):
        """
        Clears the logged in driver profile.
        """
        if self.auth.active_driver:
            driver_id = self.auth.active_driver["driver_id"]
            self.auth.active_driver = None
            self.driver_phone_number = None
            self.auth.mismatch_count = 0
            logger.info("Driver logged out")
            # Play 02/001 (driver logout success)
            self.uart.send_frame(0x02, 0x01)

    def process_attendant_login(self, attendant_id: str, full_name: str, rfid: str = ""):
        """
        Saves the logged in attendant profile.
        """
        self.auth.active_attendant = {
            "attendant_id": attendant_id,
            "full_name": full_name,
            "rfid_code": rfid
        }
        self.auth.absence_count = 0
        logger.info("Attendant logged in: %s (%s, RFID: %s)", full_name, attendant_id, rfid)
        
        # Check if students are already onboard (attendant logging in late is warned by 06/002)
        if self.students_onboard > 0:
            self.uart.send_frame(0x06, 0x02) # Phụ xe check-in sau khi đã có học sinh trên xe
        else:
            self.uart.send_frame(0x03, 0x01, attendant_id.encode("ascii")) # Phụ xe login thành công

    def process_attendant_logout(self):
        """
        Clears the logged in attendant profile.
        """
        if self.auth.active_attendant:
            self.auth.active_attendant = None
            self.auth.absence_count = 0
            logger.info("Attendant logged out")
            # Play 04/001 (attendant logout success)
            self.uart.send_frame(0x04, 0x01)
