havandat1523/School-Bus-Device/RaspberryPi/simulation/stm32_sim.py

"""
stm32_sim.py
-------------
Công cụ mô phỏng phần cứng STM32 Master độc lập cho Raspberry Pi.
Giao diện TUI Cố định 3 phần (ALL log / CMD> / Bảng lệnh) không nảy màn hình.
"""

import sys
import os
import json
import time
import threading
import collections
import serial

try:
    import mysql.connector
    MYSQL_AVAILABLE = True
except ImportError:
    MYSQL_AVAILABLE = False

PORT = sys.argv[1] if len(sys.argv) > 1 else os.getenv("UART_SIM_PORT", "COM2" if os.name == "nt" else "/tmp/ttyVIRTUAL_PI")
BAUDRATE = int(sys.argv[2]) if len(sys.argv) > 2 else 115200

# State variables
seat_states = {i: 0 for i in range(1, 17)}
gnss_state = "off"
current_lat = 21.0021
current_lon = 105.8462
current_speed = 0.0

driver_logged_in = False
active_driver_id = ""

auto_sim_running = False
auto_sim_thread = None

# ANSI Fixed Log Buffer
log_history = collections.deque(maxlen=7)
ui_lock = threading.Lock()

MAP_DIR = r"C:\Users\Admin\OneDrive\Desktop\DO_AN\Map"
if not os.path.exists(MAP_DIR):
    MAP_DIR = os.path.abspath(os.path.join(os.path.dirname(__file__), "..", "..", "Map"))

DB_CONFIG = {
    "host": "localhost",
    "user": "root",
    "password": "123456",
    "database": "schoolbus",
    "charset": "utf8mb4"
}

def add_log(msg: str):
    with ui_lock:
        timestamp = time.strftime("%H:%M:%S")
        log_history.append(f"[{timestamp}] {msg}")
        render_logs()

def draw_static_screen():
    # ANSI escape to clear screen and set up fixed 3-pane TUI layout matching user image
    sys.stdout.write("\033[2J\033[H")
    sys.stdout.write("================================================================================\n")
    sys.stdout.write("                                    ALL log                                     \n")
    sys.stdout.write("================================================================================\n")
    for _ in range(7):
        sys.stdout.write("\n")
    sys.stdout.write("--------------------------------------------------------------------------------\n")
    sys.stdout.write("CMD> \n")
    sys.stdout.write("--------------------------------------------------------------------------------\n")
    sys.stdout.write("run_system - TỰ ĐỘNG Mô phỏng xe chạy & đón học sinh (YÊU CẦU ĐÃ LOGIN)\n")
    sys.stdout.write("stop_system - Dừng chế độ mô phỏng tự động\n")
    sys.stdout.write("rfid <MÃ_THẺ> - Gửi mã thẻ RFID quẹt (VD: rfid ABX12SSDX)\n")
    sys.stdout.write("seat <SỐ_GHẾ_1_16> <0|1> - Đặt trạng thái ghế (VD: seat 3 1)\n")
    sys.stdout.write("gnss <active|degrade|off> [lat] [lon] [spd] - Đặt trạng thái GNSS\n")
    sys.stdout.write("sos - Giả lập nhấn nút SOS khẩn cấp\n")
    sys.stdout.write("dht <nhiệt_độ> <độ_ẩm> - Gửi thông số nhiệt độ/độ ẩm (VD: dht 28.5 65.0)\n")
    sys.stdout.write("status - Hiển thị trạng thái mô phỏng & tài xế hiện tại\n")
    sys.stdout.write("help / exit\n")
    sys.stdout.write("================================================================================\n")
    sys.stdout.flush()

def render_logs():
    # Saves cursor, renders top ALL LOG box (lines 4 to 10), restores cursor to CMD> line (line 12)
    sys.stdout.write("\033[s") # Save cursor
    logs_list = list(log_history)
    for idx in range(7):
        row = 4 + idx
        sys.stdout.write(f"\033[{row};1H\033[K") # Move to row, clear line
        if idx < len(logs_list):
            sys.stdout.write(logs_list[idx][:78])
    sys.stdout.write("\033[12;6H\033[K") # Return cursor to CMD> input line
    sys.stdout.flush()

def fetch_stops_from_db():
    default_stops = [
        {"file": "0.geojson", "student_name": "Tran Van C", "rfid": "04A3F1B2", "seat": 3, "address": "LK6D, Mo Lao, Ha Dong"},
        {"file": "1.geojson", "student_name": "Nguyen Van D", "rfid": "1A2B3C4D", "seat": 4, "address": "Ecolife Capitol, 58 To Huu"},
        {"file": "2.geojson", "student_name": "Le Thi E", "rfid": "2A2B3C4D", "seat": 5, "address": "Louis City Dai Mo"},
        {"file": "3.geojson", "student_name": "Pham Van F", "rfid": "3A2B3C4D", "seat": 6, "address": "Van Phuc, Ha Dong"},
        {"file": "4.geojson", "student_name": "Hoang Thi G", "rfid": "4A2B3C4D", "seat": 7, "address": "KDT Duong Noi, Ha Noi"},
        {"file": "5.geojson", "student_name": "Vu Van H", "rfid": "5A2B3C4D", "seat": 8, "address": "FLC Star Tower, Le Trong Tan"},
        {"file": "6.geojson", "student_name": "Truong Hoc", "rfid": None, "seat": None, "address": "Truong hoc"}
    ]
    if not MYSQL_AVAILABLE: return default_stops
    try:
        conn = mysql.connector.connect(**DB_CONFIG)
        cur = conn.cursor(dictionary=True)
        cur.execute("""
            SELECT r.stop_order, r.address, s.student_id, s.rfid_code, s.full_name
            FROM RouteStop r
            LEFT JOIN students s ON r.student_id = s.student_id
            WHERE r.route_id = 1 ORDER BY r.stop_order ASC
        """)
        rows = cur.fetchall()
        cur.close(); conn.close()
        if not rows: return default_stops
        stops = []
        for i, row in enumerate(rows):
            stops.append({
                "file": f"{i}.geojson",
                "student_name": row.get("full_name") or "Học sinh",
                "rfid": row.get("rfid_code") or f"RFID_{row.get('student_id')}",
                "seat": i + 2 if row.get("student_id") else None,
                "address": row.get("address") or "Điểm dừng"
            })
        return stops
    except Exception:
        return default_stops

def build_frame(main_evt: int, sub_evt: int, data: bytes = b"") -> bytes:
    length = len(data)
    frame = bytearray([0xAA, main_evt, sub_evt, length])
    frame.extend(data)
    chk = main_evt ^ sub_evt ^ length
    for b in data: chk ^= b
    frame.append(chk); frame.append(0x55)
    return bytes(frame)

class STM32Simulator:
    def __init__(self, port, baudrate):
        self.port = port
        self.baudrate = baudrate
        self.ser = None
        self.master_fd = None
        self.running = True

    def connect(self):
        try:
            self.ser = serial.Serial(self.port, self.baudrate, timeout=0.1)
            add_log(f"Connected to serial port: {self.port} at {self.baudrate} baud.")
            return True
        except Exception as e:
            if os.name != "nt":
                try:
                    import pty
                    master, slave = pty.openpty()
                    slave_name = os.ttyname(slave)
                    if os.path.exists("/tmp/ttyVIRTUAL_PI"):
                        try: os.unlink("/tmp/ttyVIRTUAL_PI")
                        except Exception: pass
                    os.symlink(slave_name, "/tmp/ttyVIRTUAL_PI")
                    self.master_fd = master
                    add_log(f"Created Linux Virtual PTY: /tmp/ttyVIRTUAL_PI -> {slave_name}")
                    return True
                except Exception as pty_err:
                    add_log(f"PTY creation error: {pty_err}")
            add_log(f"Cannot open serial port {self.port}: {e}. Console-only mode.")
            return False

    def start_receiver(self):
        t = threading.Thread(target=self._receive_loop, daemon=True)
        t.start()

    def _receive_loop(self):
        state = "STX"
        rx_main = rx_sub = rx_len = 0
        rx_data = bytearray()

        while self.running:
            try:
                data_bytes = None
                if self.ser and self.ser.is_open:
                    waiting = self.ser.in_waiting
                    if waiting > 0: data_bytes = self.ser.read(waiting)
                elif self.master_fd is not None:
                    import select
                    r, _, _ = select.select([self.master_fd], [], [], 0.1)
                    if r: data_bytes = os.read(self.master_fd, 1024)
                else:
                    time.sleep(0.5); continue

                if data_bytes:
                    for b in data_bytes:
                        if state == "STX":
                            if b == 0xAA: state = "MAIN"
                        elif state == "MAIN": rx_main = b; state = "SUB"
                        elif state == "SUB": rx_sub = b; state = "LEN"
                        elif state == "LEN":
                            rx_len = b; rx_data = bytearray()
                            state = "DATA" if rx_len > 0 else "CHECKSUM"
                        elif state == "DATA":
                            rx_data.append(b)
                            if len(rx_data) >= rx_len: state = "CHECKSUM"
                        elif state == "CHECKSUM": rx_chk = b; state = "ETX"
                        elif state == "ETX":
                            if b == 0x55:
                                chk = rx_main ^ rx_sub ^ rx_len
                                for x in rx_data: chk ^= x
                                if chk == rx_chk:
                                    self._on_frame_received(rx_main, rx_sub, rx_data)
                            state = "STX"
            except Exception:
                time.sleep(0.5)

    def _on_frame_received(self, main_evt, sub_evt, data):
        global driver_logged_in, active_driver_id
        data_str = data.decode("utf-8", errors="ignore")
        add_log(f"RECV Frame from Pi: Main=0x{main_evt:02X}, Sub=0x{sub_evt:02X}, Data='{data_str}'")
        
        if main_evt == 0x01 and sub_evt == 0x01:
            driver_logged_in = True
            active_driver_id = data_str
            add_log(f"✅ Tài xế {active_driver_id} đã ĐĂNG NHẬP THÀNH CÔNG trên Pi UI.")
        elif main_evt == 0x02 and sub_evt == 0x01:
            driver_logged_in = False
            active_driver_id = ""
            add_log("🔒 Tài xế đã ĐĂNG XUẤT THÀNH CÔNG trên Pi UI.")

        if main_evt == 0xF4:
            add_log("⏹️ NHẬN LỆNH 0xF4: DỪNG CẢNH BÁO LẶP 08/001 & DỪNG LOA!")
            return

        audio_map = {
            (0x01, 0x01): "🔊 LOA PHÁT: 01/001 - Tài xế login THÀNH CÔNG",
            (0x01, 0x02): "🔊 LOA PHÁT: 01/002 - Tài xế login THẤT BẠI",
            (0x01, 0x03): "🔊 LOA PHÁT: 01/003 - Tài xế login BẬN (chờ xác nhận phiên cũ)",
            (0x01, 0x04): "🔊 LOA PHÁT: 01/004 - Tài xế login THẤT BẠI (Server từ chối khuôn mặt)",
            (0x02, 0x01): "🔊 LOA PHÁT: 02/001 - Tài xế logout THÀNH CÔNG",
            (0x02, 0x03): "🔊 LOA PHÁT: 02/003 - Tài xế logout THẤT BẠI (Khuôn mặt không khớp)",
            (0x02, 0x04): "🔊 LOA PHÁT: 02/004 - Tài xế logout THẤT BẠI (Còn học sinh/phụ xe trên xe)",
            (0x03, 0x01): "🔊 LOA PHÁT: 03/001 - Phụ xe login THÀNH CÔNG",
            (0x04, 0x01): "🔊 LOA PHÁT: 04/001 - Phụ xe logout THÀNH CÔNG",
            (0x05, 0x01): "🔊 LOA PHÁT: 05/001 - Học sinh quẹt thẻ THÀNH CÔNG",
            (0x05, 0x03): "🔊 LOA PHÁT: 05/003 - Học sinh cuối cùng đã lên xe (Chiều đón)",
            (0x05, 0x04): "🔊 LOA PHÁT: 05/004 - Học sinh cuối cùng đã xuống xe (Chiều trả)",
            (0x05, 0x06): "🔊 LOA PHÁT: 05/006 - Xuống xe hàng loạt tại trường. Bác tài & phụ xe kiểm tra xe!",
            (0x05, 0x08): "🔊 LOA PHÁT: 05/008 - Thẻ hợp lệ! Mời học sinh vào vị trí ghế ngồi",
            (0x05, 0x09): "🔊 LOA PHÁT: 05/009 - Quẹt thẻ đã hết hạn 5 phút (chưa vào ghế)",
            (0x07, 0x01): "🚨 LOA PHÁT: 07/001 - CẢNH BÁO SOS KHẨN CẤP",
            (0x07, 0x02): "🚨 LOA PHÁT: 07/002 - SOS Lần 2 (Chưa nhận phản hồi)",
            (0x07, 0x03): "🚨 LOA PHÁT: 07/003 - SOS Lần 3 (Chuẩn bị gọi khẩn cấp)",
            (0x07, 0x04): "🚨 LOA PHÁT: 07/004 - Đang kết nối cuộc gọi khẩn cấp",
            (0x07, 0x05): "🚨 LOA PHÁT: 07/005 - Cuộc gọi khẩn cấp hoàn tất",
            (0x08, 0x01): "🚨 LOA PHÁT: 08/001 - CẢNH BÁO: HỌC SINH TRÊN XE KHÔNG CÓ TÀI XẾ/PHỤ XE!",
        }
        key = (main_evt, sub_evt)
        if key in audio_map:
            add_log(audio_map[key])

    def send_data(self, frame: bytes):
        if self.ser and self.ser.is_open:
            try:
                self.ser.write(frame)
                add_log(f"SENT Frame ({len(frame)} bytes): {frame.hex().upper()}")
            except Exception as e:
                add_log(f"Send error: {e}")
        elif self.master_fd is not None:
            try:
                os.write(self.master_fd, frame)
                add_log(f"SENT Frame via PTY ({len(frame)} bytes): {frame.hex().upper()}")
            except Exception as e:
                add_log(f"PTY send error: {e}")
        else:
            add_log(f"[Simulated Out] Frame ({len(frame)} bytes): {frame.hex().upper()}")

def send_seats(sim: STM32Simulator):
    seat_str = "".join([f"s{i}:{seat_states[i]}" for i in range(1, 17)])
    frame = build_frame(0xF1, 0x00, seat_str.encode("ascii"))
    sim.send_data(frame)

def send_gnss(sim: STM32Simulator, lat, lon, speed):
    gps_str = f"{lat:.6f},{lon:.6f},{speed:.1f}"
    frame = build_frame(0xF0, 0x00, gps_str.encode("ascii"))
    sim.send_data(frame)

def load_geojson_coordinates(filepath):
    try:
        with open(filepath, "r", encoding="utf-8") as f:
            data = json.load(f)
        return data["geometry"]["coordinates"]
    except Exception:
        return []

def run_system_simulation(sim: STM32Simulator):
    global auto_sim_running, current_lat, current_lon, current_speed
    auto_sim_running = True
    stops = fetch_stops_from_db()
    
    add_log("🚀 BẮT ĐẦU MÔ PHỎNG TỰ ĐỘNG XE DI CHUYỂN & ĐÓN HỌC SINH")

    seat_states[1] = 1; seat_states[2] = 1
    send_seats(sim)
    time.sleep(1.5)

    for idx, stop in enumerate(stops):
        if not auto_sim_running: break

        geojson_path = os.path.join(MAP_DIR, stop["file"])
        coords = load_geojson_coordinates(geojson_path)
        if not coords: continue

        add_log(f"🚌 [ĐOẠN {idx+1}/{len(stops)}] Xe di chuyển đến: {stop['address']}")

        step = max(1, len(coords) // 25)
        sampled_coords = coords[::step]
        if coords[-1] not in sampled_coords: sampled_coords.append(coords[-1])

        speed = 35.0
        for lon, lat in sampled_coords:
            if not auto_sim_running: break
            current_lat = lat; current_lon = lon; current_speed = speed
            send_gnss(sim, lat, lon, speed)
            time.sleep(0.3)

        if not auto_sim_running: break

        current_speed = 0.0
        send_gnss(sim, current_lat, current_lon, 0.0)
        add_log(f"📍 XE ĐÃ TỚI ĐIỂM DỪNG: {stop['address']}")

        if stop["rfid"] and stop["seat"]:
            add_log(f"💳 [QUẸT THẺ] {stop['student_name']} (Thẻ: {stop['rfid']})")
            rfid_frame = build_frame(0xF2, 0x00, stop["rfid"].encode("ascii"))
            sim.send_data(rfid_frame)
            time.sleep(1.0)

            add_log(f"🪑 [VÀO GHẾ] {stop['student_name']} ngồi Ghế {stop['seat']}")
            seat_states[stop["seat"]] = 1
            send_seats(sim)
            time.sleep(2.5)
        elif idx == len(stops) - 1:
            add_log("🏫 Xe đã về đến trường học! Học sinh xuống xe hàng loạt.")
            for s in range(3, 17): seat_states[s] = 0
            send_seats(sim)
            time.sleep(2.0)

    auto_sim_running = False
    add_log("✅ HOÀN THÀNH CHUYẾN ĐI! Xe đã về đến trường.")

def main():
    draw_static_screen()
    add_log("STM32 Master Hardware Simulator started.")

    sim = STM32Simulator(PORT, BAUDRATE)
    sim.connect()
    sim.start_receiver()

    global gnss_state, current_lat, current_lon, current_speed, auto_sim_running, auto_sim_thread, driver_logged_in

    try:
        while True:
            # Position cursor on line 12 for CMD> prompt
            sys.stdout.write("\033[12;6H\033[K")
            sys.stdout.flush()
            cmd = input().strip()
            if not cmd: continue

            parts = cmd.split()
            op = parts[0].lower()

            if op in ("exit", "quit"):
                add_log("Exiting simulator.")
                auto_sim_running = False
                sim.running = False
                break

            elif op == "help":
                draw_static_screen()
                render_logs()

            elif op == "run_system":
                if not driver_logged_in:
                    add_log("❌ LỖI: Tài xế CHƯA ĐĂNG NHẬP trên giao diện Pi UI!")
                elif auto_sim_running:
                    add_log("Mô phỏng tự động đang chạy.")
                else:
                    auto_sim_thread = threading.Thread(target=run_system_simulation, args=(sim,), daemon=True)
                    auto_sim_thread.start()

            elif op == "stop_system":
                if auto_sim_running:
                    add_log("Đang dừng mô phỏng tự động...")
                    auto_sim_running = False

            elif op == "status":
                add_log(f"Driver Logged: {driver_logged_in} ({active_driver_id}) | GNSS: {gnss_state.upper()} | Speed: {current_speed}km/h")

            elif op == "rfid":
                if len(parts) >= 2:
                    code = parts[1]
                    add_log(f"Gửi quẹt thẻ RFID: {code}")
                    frame = build_frame(0xF2, 0x00, code.encode("ascii"))
                    sim.send_data(frame)

            elif op == "seat":
                if len(parts) >= 3:
                    try:
                        s_num = int(parts[1]); val = int(parts[2])
                        if 1 <= s_num <= 16 and val in (0, 1):
                            seat_states[s_num] = val
                            add_log(f"Cập nhật Ghế {s_num} -> {val}")
                            send_seats(sim)
                    except ValueError: pass

            elif op == "gnss":
                if len(parts) >= 2:
                    st = parts[1].lower()
                    if st in ("active", "degrade", "off"):
                        gnss_state = st
                        if len(parts) >= 5:
                            try:
                                current_lat = float(parts[2])
                                current_lon = float(parts[3])
                                current_speed = float(parts[4])
                            except ValueError: pass
                        add_log(f"Cập nhật GNSS -> {st.upper()} (Lat: {current_lat}, Lon: {current_lon}, Speed: {current_speed}km/h)")
                        send_gnss(sim, current_lat, current_lon, current_speed)

            elif op == "sos":
                add_log("TRIGGER SOS KHẨN CẤP!")
                frame = build_frame(0xF3, 0x01, b"\x01")
                sim.send_data(frame)

            elif op == "dht":
                if len(parts) >= 3:
                    try:
                        temp = float(parts[1]); humid = float(parts[2])
                        add_log(f"Gửi cảm biến DHT11 -> Temp: {temp}C, Humid: {humid}%")
                        dht_str = f"{temp:.1f},{humid:.1f}"
                        frame = build_frame(0xF5, 0x00, dht_str.encode("ascii"))
                        sim.send_data(frame)
                    except ValueError: pass

    except KeyboardInterrupt:
        sim.running = False

if __name__ == "__main__":
    main()
