havandat1523/School-Bus-Device/(commit log)

2026-10-08 Initial commit: add Raspberry Pi, STM32 and simulation
2026-10-08 Fix Raspberry Pi as regular source directory
    [app.py, at_commands.py, boarding_logic.py, config.py, gpio_handler.py, main.py, mqtt_client.py, payload_handler.py]
